sdadsp/LEDMAT3/FPGA/LED_MAT3_REV2/docs/basic_requirements.docx

20171005

Refresh rate measurements:

PWM Quantum | Number of Panels | Color Depth | Timing Data
1 (50 ns @ 20MHz SCLK) | 5 (64x64) | 8 bit @ color | 1-bit Line WR Cycle: 16 us Line WR Cycle: 144 us Frame Cycle: 4.6 ms Refresh Rate: 217Hz
15 (760 ns @ 20MHz) | 5 | 8 bit | Line WR Cycle: 322 us Frame Cycle: 10 ms Refresh Rate: 100Hz

20171006

Controls:

| OFF | ON
SW[9] | DPI Clock Input | Internal 25 MHz

Prices comparison:

10M40DCF256C8G (http://analytics.supplyframe.com/trackingservlet/track/) | 10M25DAF256C8G (http://analytics.supplyframe.com/trackingservlet/track/) | 10CL040YF484I7G (http://analytics.supplyframe.com/trackingservlet/track/) | 10CL025YU256I7G (http://analytics.supplyframe.com/trackingservlet/track/)
RAM: 1,260 Kb | 675 Kb | 1,134 Kb | 594 Kb
LED Modules: 12 x (64x64) | 6 x (64x64) | 10 x (64x64) | 6 x (64x64)
Price: $60 (it is possible to upgrade to 10M50) (it is possible downgrade to $50 10M25) | $50 (it is possible to downgrade to $30 10M16) | $40 (it is possible to upgrade to 10CL055) (it is NOT possible to downgrade to 10CL025) | $25 (it is NOT possible to upgrade to 10CL040) (it is possible to downgrade to $30 10CL016)
Additionally: | | + EPCQ16 ($7) | + EPCQ16 ($7)
Price: | | = $47 | = $32

Additionally: + QSPI ($2)

Additionally: + PSU ($5)

Additionally: + Connectors/Switches ($3)

Additionally: + PCB ($5)
Price: $75 | $65 | $62 | $47
Resources: | | + 2 weeks for SCH/PCB
| + 1 month design time to add external memory + $5 – memory chip | | + 1 month design time to add external memory + $5 – memory chip
Total: $75 | $70 | $67 | $53

Required resources

Nnumbers of pins:

CLOCKS | 3
SDRAM | 39
VGA | 14
KEYS | 2
LEDS | 2
SWITHES | 2
HUB75 | 42
DPI | 28
QSPI | 6
UART | 2
I2C | 2
MCU Interface | 4
TOTAL: | 146

- BGA256

Memory:

LED Panels: | Bits:
12 x (64x64) | 1,179,648
10 x (64x64) | 983,040
6 x (64x64) | 589,824
