sdadsp/LEDMAT3/FPGA/LED_MAT3_REV2/docs/20180509_files_list.docx

LED_MATRIX

The modules in the firmware project (by 20171105):

top.v | Top interconnections module
defines.vh | Main parameters
version_num.v version_num.tcl | Firmware version – vector connected to the registers’ file
test_pattern_generator.v vga_controller.v video_sync_generator.v video_address_generator.v | Test pattern generator
uart_rxtx.v uart.v uart_fifo.v | UART
dpi_sync_detector.v | Input data sync detector
freq_measure.v | Input video data frequency meter
stb_extender.v | strobe extender (to transfer a strobe from a fast to the slow clock domain)
strobe_gen_1k_10_5_1.v | Time-based strobes generator
regfile_uart_mapper.v | Registers’ file
pwm.v | PWM for brightness control
pll1.v | Main PLL
pll_video_input.v | DPI (Video) input PLL
outbuf_dpram.v | Video-buffer with initialization by logo2_.mif
hub75_drv.v | MBI5124 and ICN2038 -based LED matrix’s driver
~~\mbi5153_drv\~~ ~~mbi5153_~~~~commands.v~~ ~~mbi5153_~~~~data.v~~ ~~mbi5153_~~~~frame.v~~ ~~mbi5153_~~~~top.v~~ ~~fsm_rq_~~~~rdy.v~~ | ~~Files for supporting MBI5153 driver~~ ~~Sending commands~~ ~~Sending video-data (1 line per request)~~ ~~Sending 1 frame~~ ~~Config, send frame, send~~ ~~VSync~~~~, GCLK control, etc.~~ ~~Latching request and interacting with its end~~ ~~“~~~~customer~~~~”~~
image_clipper.v | DPI (Video) data clipping
dpi_recevier.v | Simple input video-data synchronizer & counter

Tools:

bmp256x64_2mif.m – make a MIF logo for initializing DPRAM

bmp360x90_2_bmp120x270.m – converting a picture for the matrix driven by Linsn modules
