sdadsp/LEDMAT3/PCB/LED_MAT_3/Release2/Project Outputs for LED_MAT_3/Fabrication/Report Board Stack/LED_MAT_3_2.0(2018-09-01).xls

Board Stack Report
Stack Up |  | Layer Stack
Layer | Board Layer Stack | Name | Material | Thickness | Constant
1 |  | Top Paste
2 |  | Top Overlay
3 |  | Top Solder | Solder Resist | 0.010mm | 3.5
4 |  | Top Layer | Copper | 0.018mm
5 |  | Dielectric 1 | 2x1080 | 0.132mm | 4.2
6 |  | Internal Plane 1 | Copper | 0.036mm
7 |  | Dielectric 4 | FR-4 | 0.450mm | 4.2
8 |  | Signal Layer 1 | Copper | 0.036mm
9 |  | Dielectric 5 | 3x1080 | 0.198mm | 4.2
10 |  | Signal Layer 2 | Copper | 0.036mm
11 |  | Dielectric 3 | FR-4 | 0.450mm | 4.2
12 |  | Internal Plane 2 | Copper | 0.036mm
13 |  | Dielectric 2 | 2x1080 | 0.132mm | 4.2
14 |  | Bottom Layer | Copper | 0.018mm
15 |  | Bottom Solder | Solder Resist | 0.010mm | 3.5
16 |  | Bottom Overlay
17 |  | Bottom Paste
 | Height : 1.562mm
