sdadsp/LEDMAT3/FPGA/LED_MAT3_REV2/docs/mbi5153_drv_and_memory_map.docx

// Date: 20171206 // Author: DS // “How to program MBI5153”

Suppose, we have 3 (M) driver ICs connected into the chain, and each IC has 4 (N) channels.

Define the uppermost pixel address in the row (line) : UPA = LBA + N · M - 1;

Then the image map in the memory will be looked as following:

1) RAM_ADDR = UPA

RAM_ADDR | LBA (Line Base Addr) | | | UPA – 2N | | | | UPA - N | | | | UPA
Line0 | IC1 Ch0 | IC1 Ch1 | IC1 Ch2 | IC1 Ch3 | IC2 Ch0 | IC2 Ch1 | IC2 Ch2 | IC2 Ch3 | IC3 Ch0 | IC3 Ch1 | IC3 Ch2 | IC3 Ch3
Line1 | IC1 Ch0 | IC1 Ch1 | IC1 Ch2 | IC1 Ch3 | IC2 Ch0 | IC2 Ch1 | IC2 Ch2 | IC2 Ch3 | IC3 Ch0 | IC3 Ch1 | IC3 Ch2 | IC3 Ch3
Line2 | IC1 Ch0 | IC1 Ch1 | IC1 Ch2 | IC1 Ch3 | IC2 Ch0 | IC2 Ch1 | IC2 Ch2 | IC2 Ch3 | IC3 Ch0 | IC3 Ch1 | IC3 Ch2 | IC3 Ch3

2) RAM_ADDR = UPA – 1

RAM_ADDR | | | UPA – 1 – 2N | | | | UPA – 1 – N | | | | UPA - 1
Line0 | IC1 Ch0 | IC1 Ch1 | IC1 Ch2 | IC1 Ch3 | IC2 Ch0 | IC2 Ch1 | IC2 Ch2 | IC2 Ch3 | IC3 Ch0 | IC3 Ch1 | IC3 Ch2 | IC3 Ch3
Line1 | IC1 Ch0 | IC1 Ch1 | IC1 Ch2 | IC1 Ch3 | IC2 Ch0 | IC2 Ch1 | IC2 Ch2 | IC2 Ch3 | IC3 Ch0 | IC3 Ch1 | IC3 Ch2 | IC3 Ch3
Line2 | IC1 Ch0 | IC1 Ch1 | IC1 Ch2 | IC1 Ch3 | IC2 Ch0 | IC2 Ch1 | IC2 Ch2 | IC2 Ch3 | IC3 Ch0 | IC3 Ch1 | IC3 Ch2 | IC3 Ch3

3) RAM_ADDR = UPA – 2

RAM_ADDR | | UPA – 2 – 2N | | | | UPA – 2 – N | | | | UPA - 2
Line0 | IC1 Ch0 | IC1 Ch1 | IC1 Ch2 | IC1 Ch3 | IC2 Ch0 | IC2 Ch1 | IC2 Ch2 | IC2 Ch3 | IC3 Ch0 | IC3 Ch1 | IC3 Ch2 | IC3 Ch3
Line1 | IC1 Ch0 | IC1 Ch1 | IC1 Ch2 | IC1 Ch3 | IC2 Ch0 | IC2 Ch1 | IC2 Ch2 | IC2 Ch3 | IC3 Ch0 | IC3 Ch1 | IC3 Ch2 | IC3 Ch3
Line2 | IC1 Ch0 | IC1 Ch1 | IC1 Ch2 | IC1 Ch3 | IC2 Ch0 | IC2 Ch1 | IC2 Ch2 | IC2 Ch3 | IC3 Ch0 | IC3 Ch1 | IC3 Ch2 | IC3 Ch3

4) RAM_ADDR = UPA – 3

RAM_ADDR | UPA – 3 – 2N | | | | UPA – 3 – N | | | | UPA - 3
Line0 | IC1 Ch0 | IC1 Ch1 | IC1 Ch2 | IC1 Ch3 | IC2 Ch0 | IC2 Ch1 | IC2 Ch2 | IC2 Ch3 | IC3 Ch0 | IC3 Ch1 | IC3 Ch2 | IC3 Ch3
Line1 | IC1 Ch0 | IC1 Ch1 | IC1 Ch2 | IC1 Ch3 | IC2 Ch0 | IC2 Ch1 | IC2 Ch2 | IC2 Ch3 | IC3 Ch0 | IC3 Ch1 | IC3 Ch2 | IC3 Ch3
Line2 | IC1 Ch0 | IC1 Ch1 | IC1 Ch2 | IC1 Ch3 | IC2 Ch0 | IC2 Ch1 | IC2 Ch2 | IC2 Ch3 | IC3 Ch0 | IC3 Ch1 | IC3 Ch2 | IC3 Ch3

Next Line:

1) UPA = UPA + N · M

RAM_ADDR | LBA (Line Base Addr) | | | UPA – 2N | | | | UPA - N | | | | UPA
Line0 | IC1 Ch0 | IC1 Ch1 | IC1 Ch2 | IC1 Ch3 | IC2 Ch0 | IC2 Ch1 | IC2 Ch2 | IC2 Ch3 | IC3 Ch0 | IC3 Ch1 | IC3 Ch2 | IC3 Ch3
Line1 | IC1 Ch0 | IC1 Ch1 | IC1 Ch2 | IC1 Ch3 | IC2 Ch0 | IC2 Ch1 | IC2 Ch2 | IC2 Ch3 | IC3 Ch0 | IC3 Ch1 | IC3 Ch2 | IC3 Ch3
Line2 | IC1 Ch0 | IC1 Ch1 | IC1 Ch2 | IC1 Ch3 | IC2 Ch0 | IC2 Ch1 | IC2 Ch2 | IC2 Ch3 | IC3 Ch0 | IC3 Ch1 | IC3 Ch2 | IC3 Ch3
