sdadsp/LEDMAT3/FPGA/LED_MAT3_REV2/docs/led_array_controller_rev2.jpg

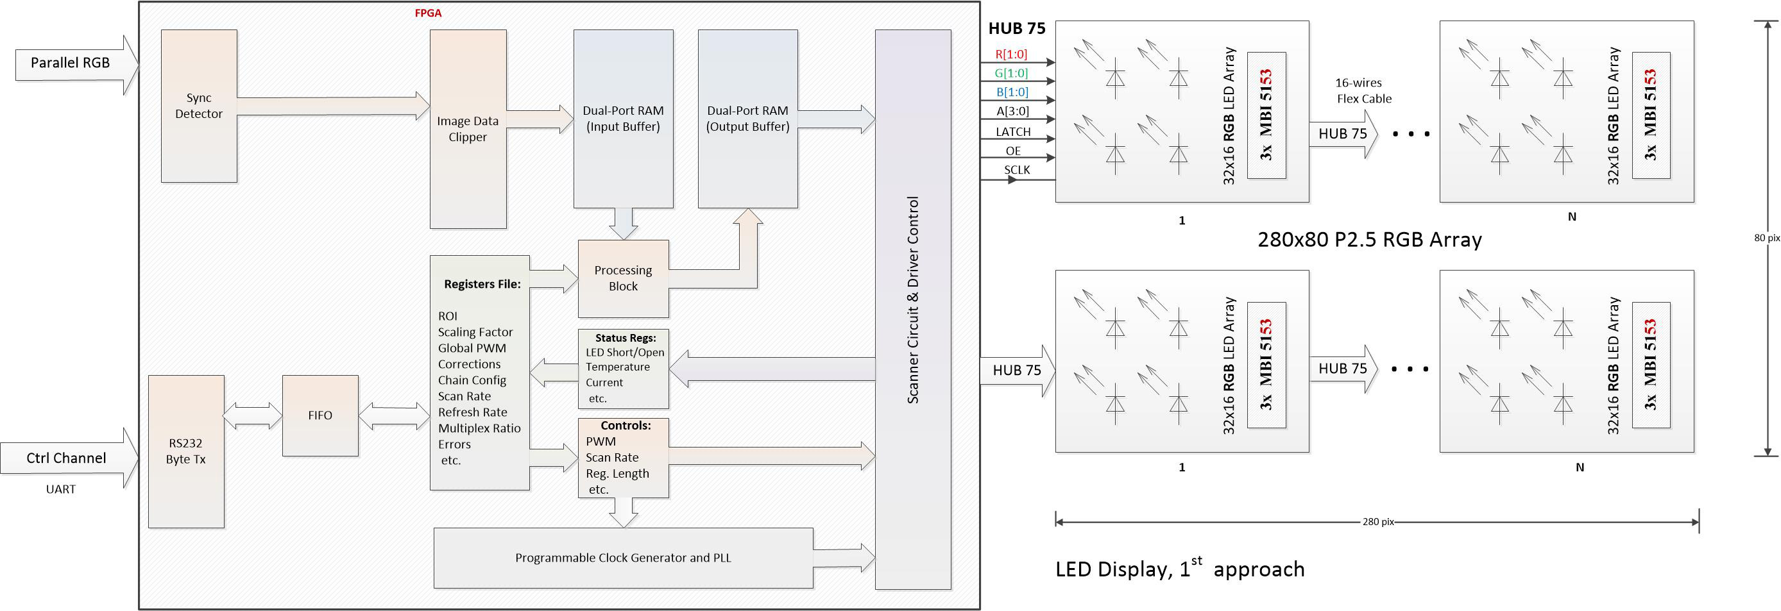
FPGA/LED_MAT3_REV2/docs/led_array_controller_rev2.jpg
