sdadsp/LEDMAT3/FPGA/LED_MAT3_REV2/docs/led_matrix_clock_tree_v1.jpg

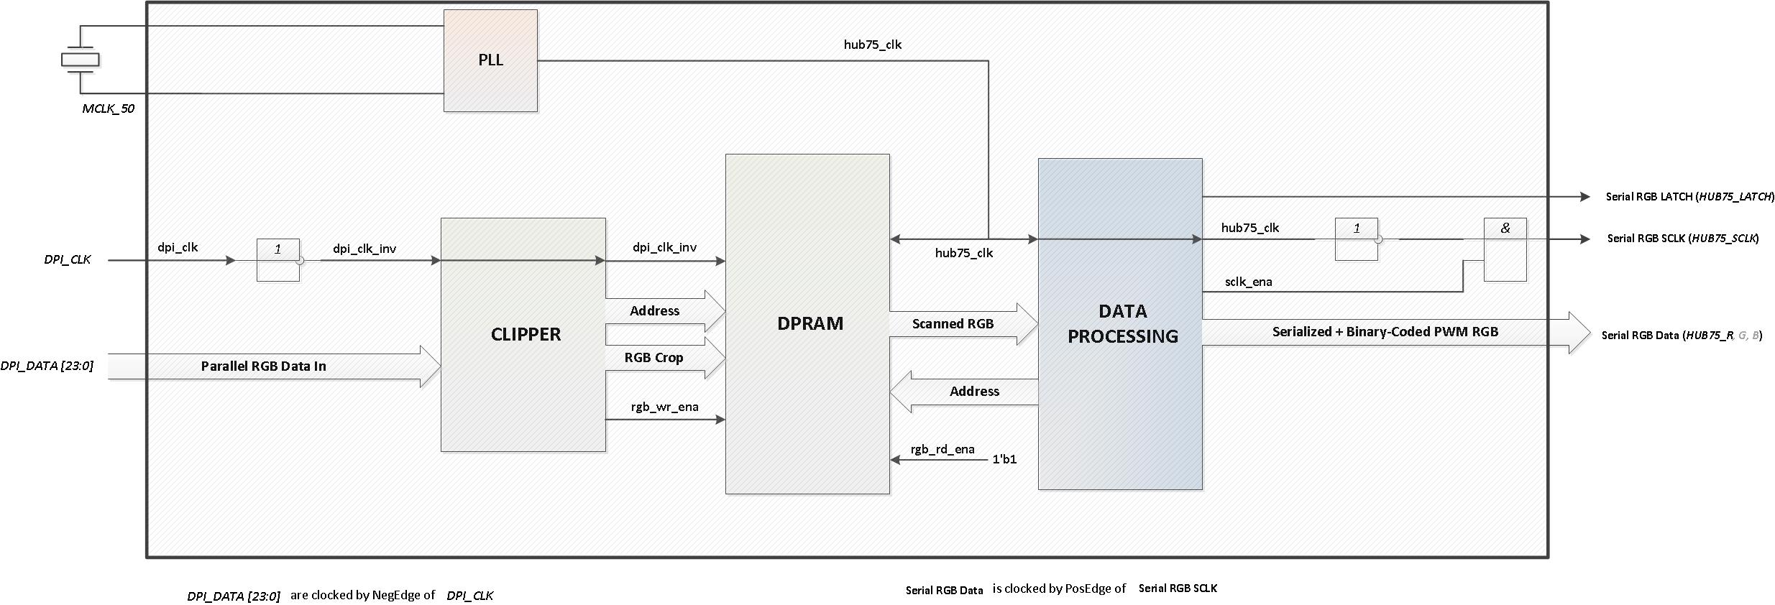
FPGA/LED_MAT3_REV2/docs/led_matrix_clock_tree_v1.jpg
