sdadsp/LEDMAT3/FPGA/LED_MAT3_REV2/hub75_drv/simulation/20170901/2.JPG

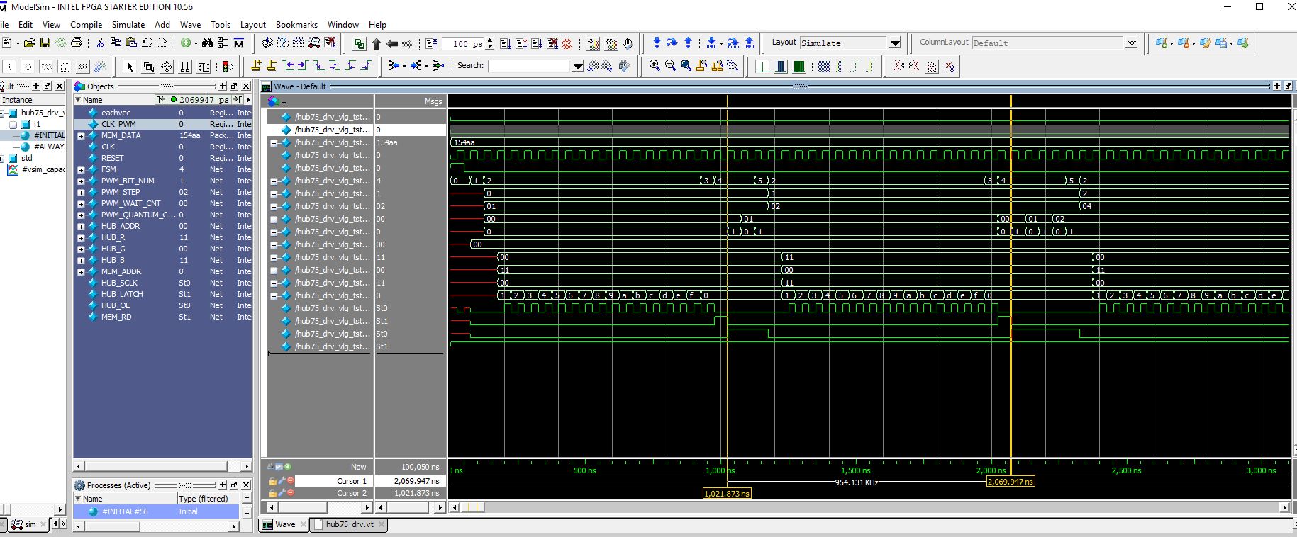
FPGA/LED_MAT3_REV2/hub75_drv/simulation/20170901/2.JPG
