sdadsp/LEDMAT3/FPGA/LED_MAT3_REV2/mbi5153_drv/simulations/mbi5153_commands/temp/wave_201710271730.bmp

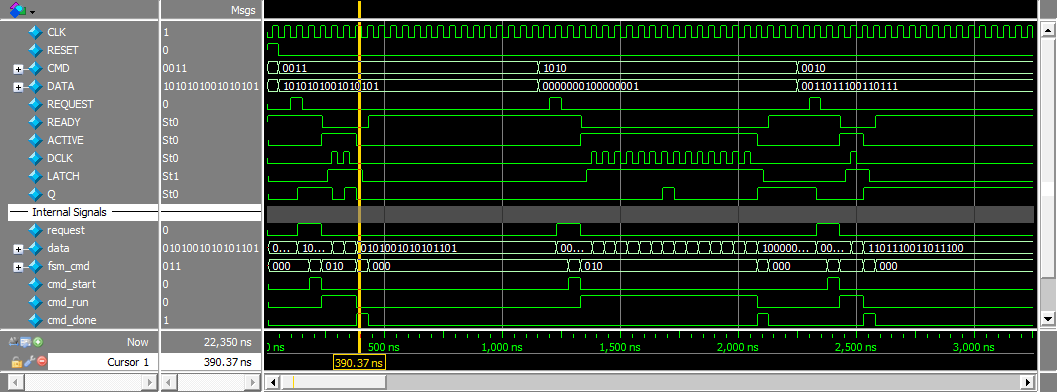
FPGA/LED_MAT3_REV2/mbi5153_drv/simulations/mbi5153_commands/temp/wave_201710271730.bmp
