sdadsp/LEDMAT3/FPGA/LED_MAT3_REV2/mbi5153_drv/simulations/mbi5153_data/201712141727_mbi5153_data_sim_out.bmp

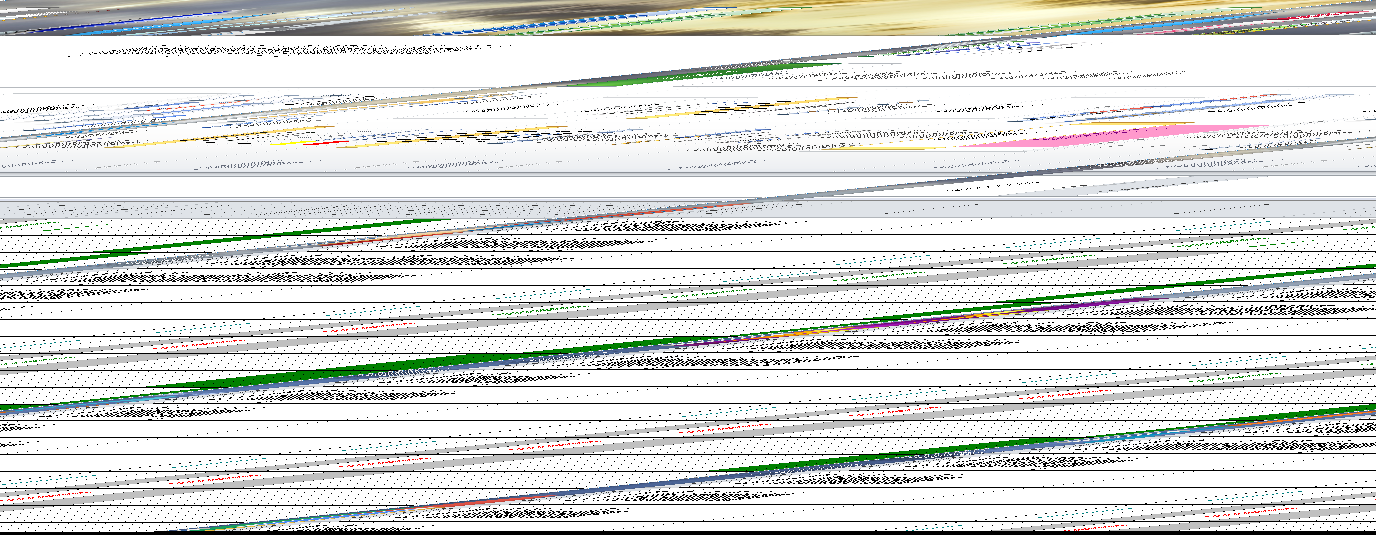
FPGA/LED_MAT3_REV2/mbi5153_drv/simulations/mbi5153_data/201712141727_mbi5153_data_sim_out.bmp
