sdadsp/LEDMAT3/FPGA/LED_MAT3_REV2/mbi5153_drv/simulations/mbi5153_data/201712181715_mbi5153_data_sim_out.png

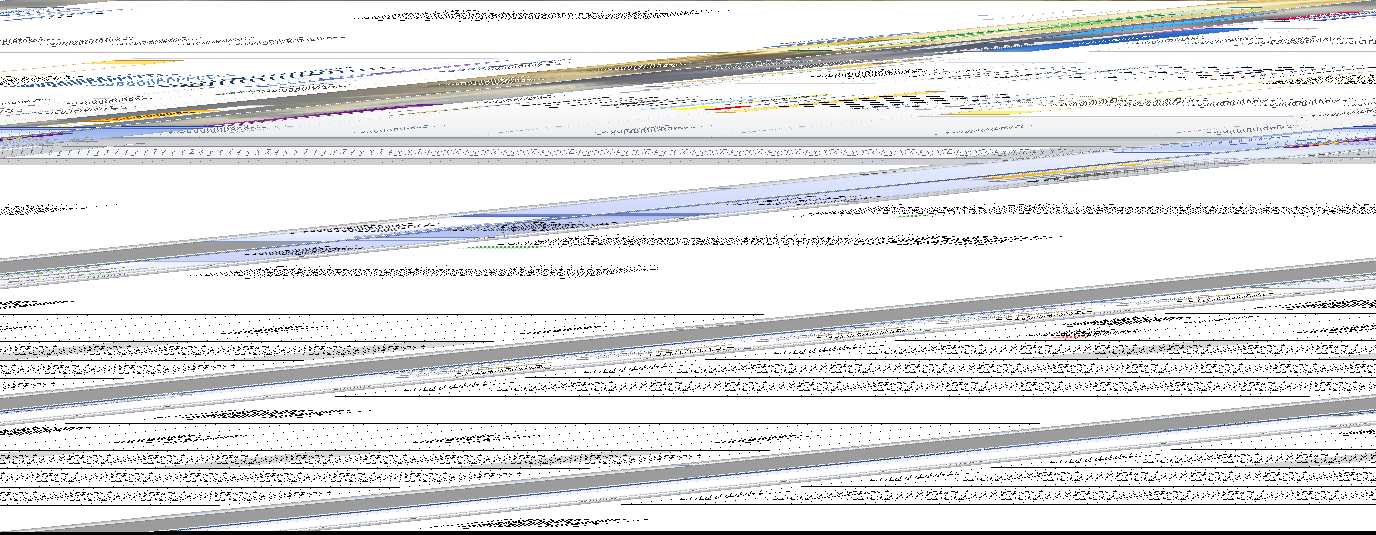
FPGA/LED_MAT3_REV2/mbi5153_drv/simulations/mbi5153_data/201712181715_mbi5153_data_sim_out.png
