sdadsp/LEDMAT3/FPGA/LED_MAT3_REV2/mbi5153_drv/simulations/mbi5153_data/temp/201711241648.bmp

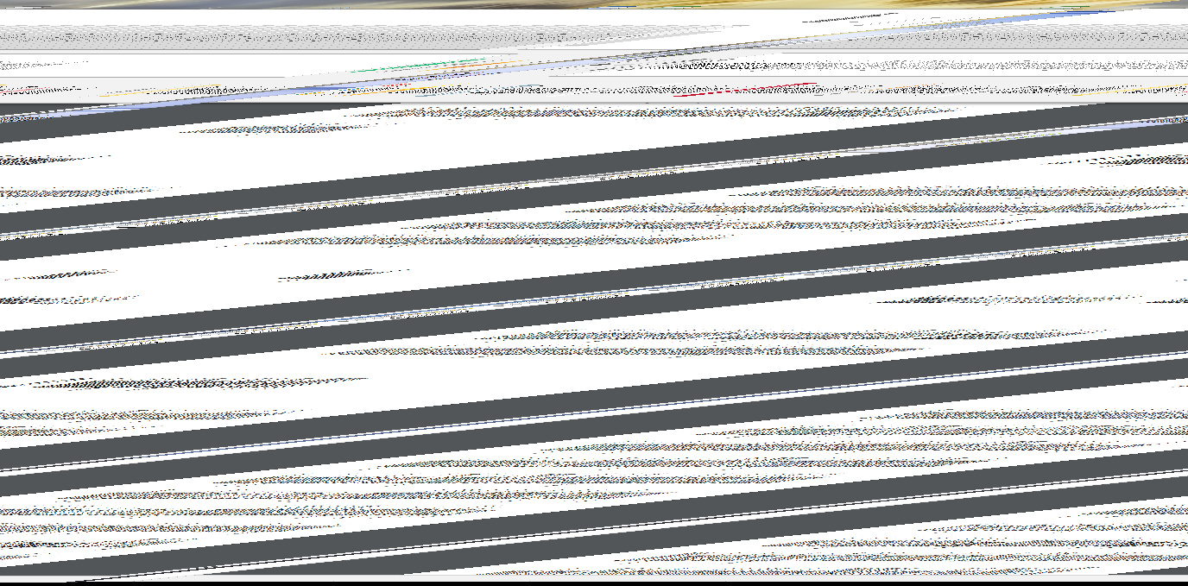
FPGA/LED_MAT3_REV2/mbi5153_drv/simulations/mbi5153_data/temp/201711241648.bmp
