sdadsp/LEDMAT3/FPGA/LED_MAT3_REV2/mbi5153_drv/simulations/mbi5153_data/wave_201801201655_2.JPG

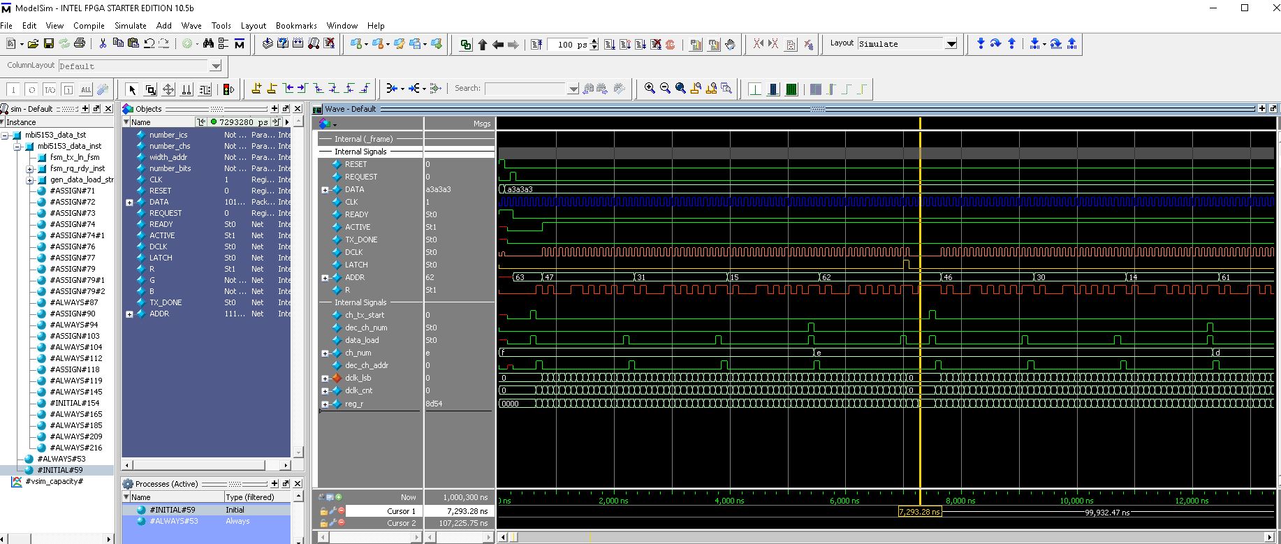
FPGA/LED_MAT3_REV2/mbi5153_drv/simulations/mbi5153_data/wave_201801201655_2.JPG
