sdadsp/LEDMAT3/FPGA/LED_MAT3_REV2/mbi5153_drv/simulations/mbi5153_rcfg/wave_20180112_1st-approach.JPG

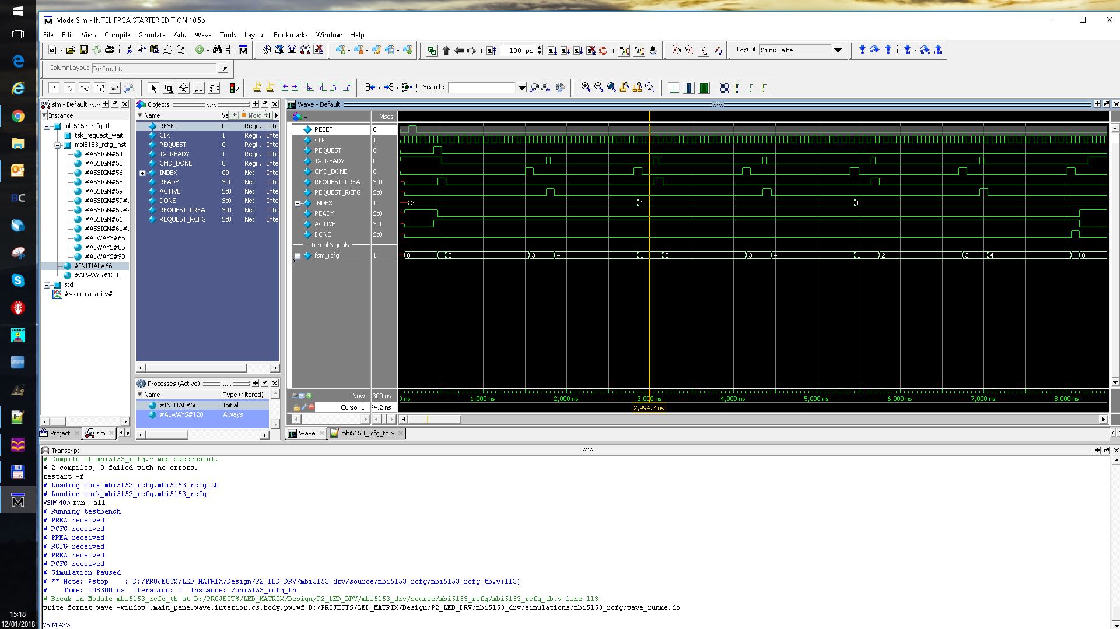
FPGA/LED_MAT3_REV2/mbi5153_drv/simulations/mbi5153_rcfg/wave_20180112_1st-approach.JPG
