sdadsp/LEDMAT3/FPGA/LED_MAT3_REV2/mbi5153_drv/simulations/mbi5153_rcfg_cmd/wave_20180113_rcfg_1-cycle.JPG

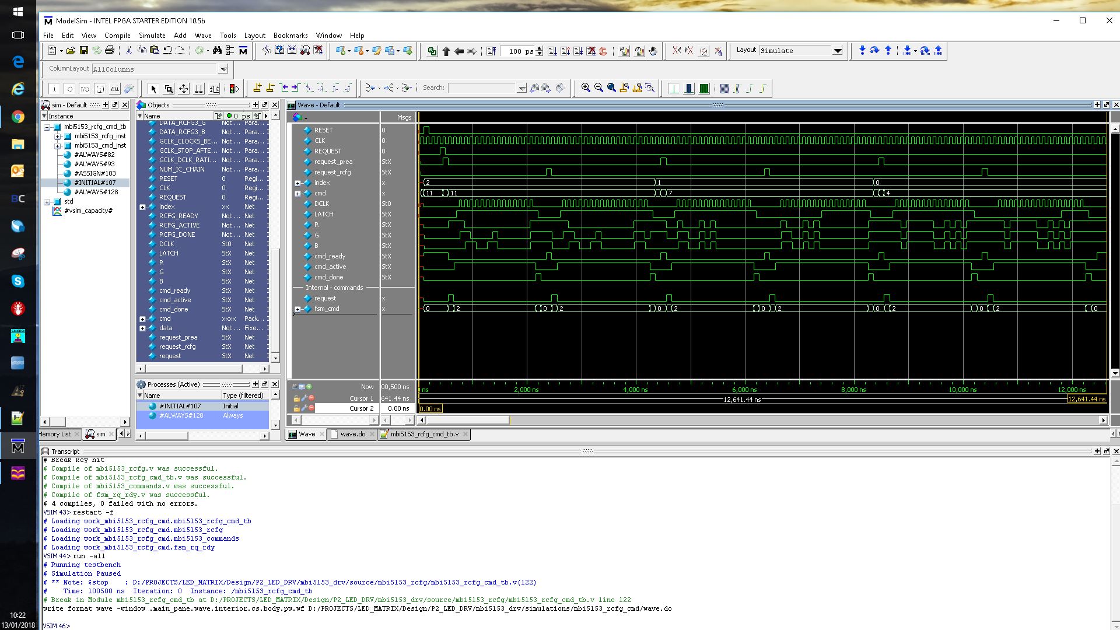
FPGA/LED_MAT3_REV2/mbi5153_drv/simulations/mbi5153_rcfg_cmd/wave_20180113_rcfg_1-cycle.JPG
