sdadsp/LEDMAT3/FPGA/LED_MAT3_REV2/mbi5153_drv/simulations/mbi5153_top/20180125/config_registers_writing (reg3).PNG

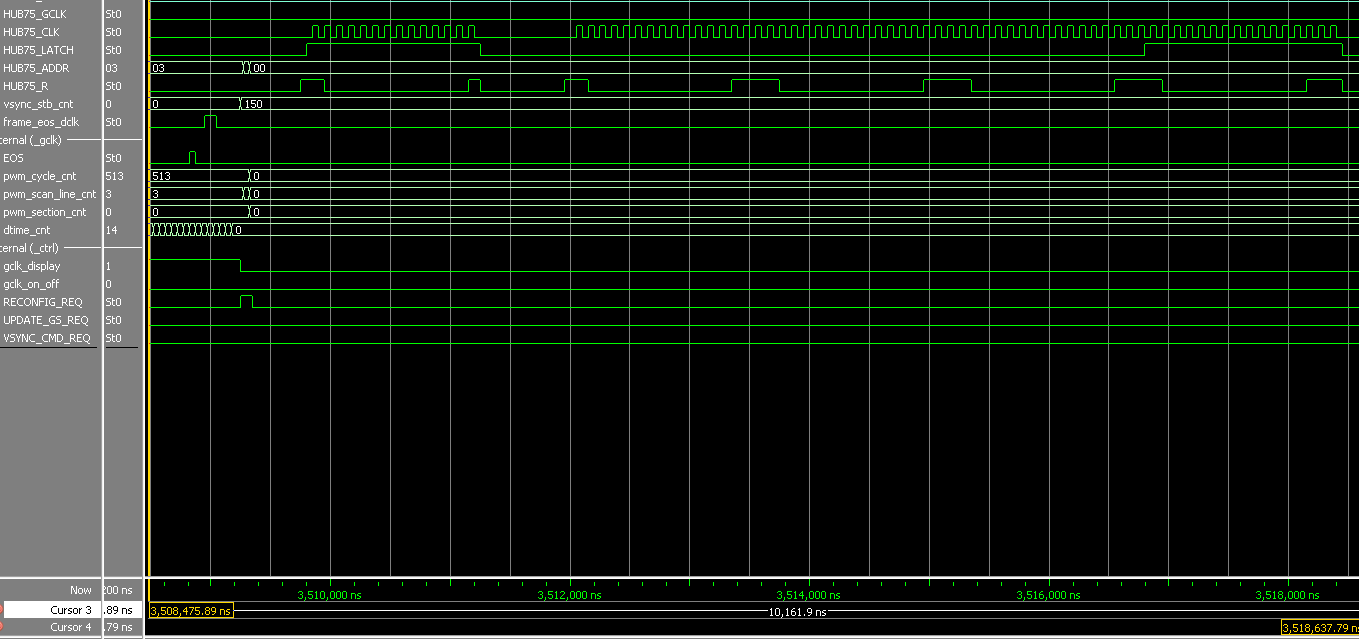
FPGA/LED_MAT3_REV2/mbi5153_drv/simulations/mbi5153_top/20180125/config_registers_writing (reg3).PNG
