sdadsp/LEDMAT3/FPGA/LED_MAT3_REV2/mbi5153_drv/simulations/mbi5153_top/20180125/dead_time_between_sections.PNG

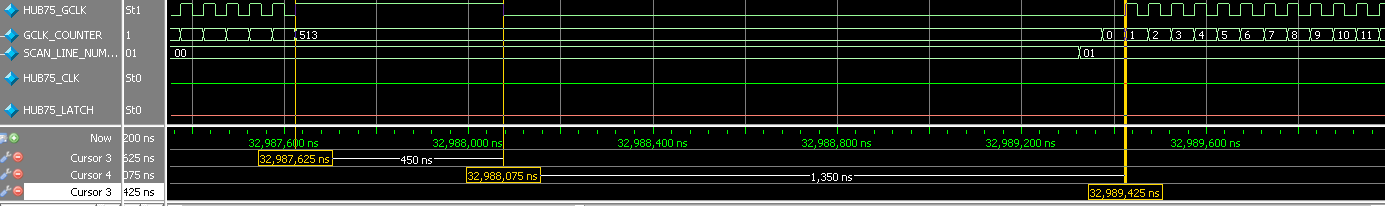
FPGA/LED_MAT3_REV2/mbi5153_drv/simulations/mbi5153_top/20180125/dead_time_between_sections.PNG
