sdadsp/LEDMAT3/FPGA/LED_MAT3_REV2/mbi5153_drv/simulations/mbi5153_top/20180125/end-of-update_GS_and_VSYNC_and_beginning_of_displaying_GS (frame scan).PNG

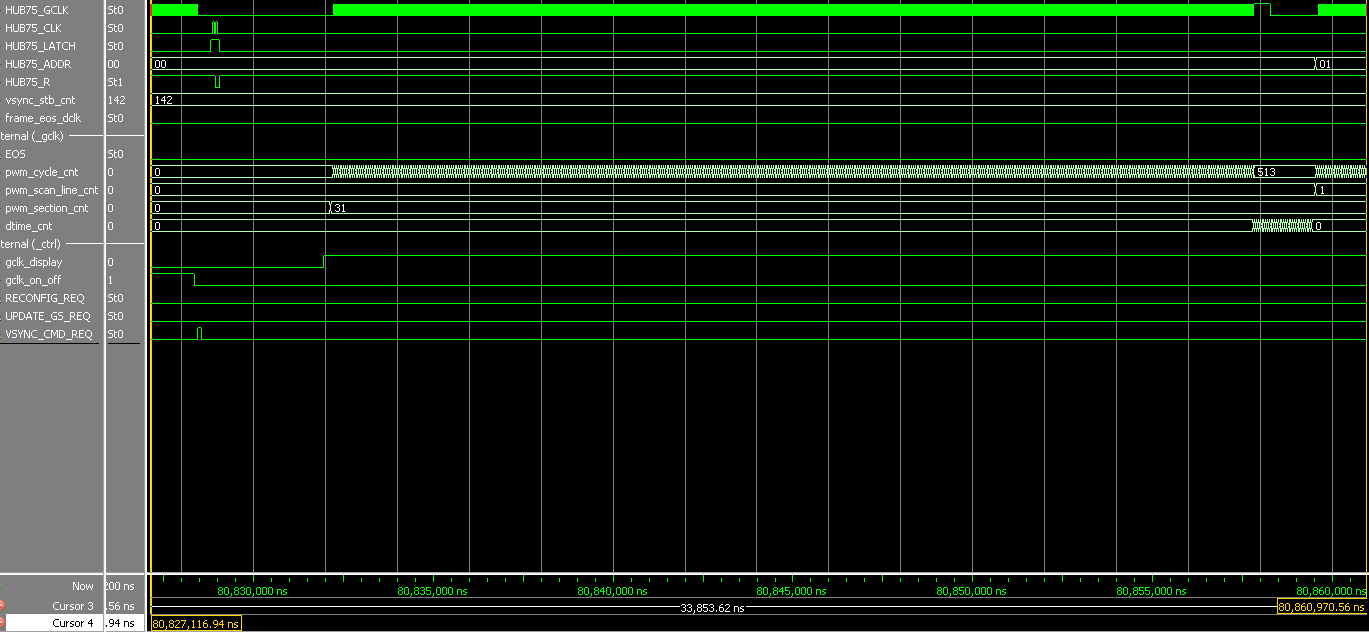
FPGA/LED_MAT3_REV2/mbi5153_drv/simulations/mbi5153_top/20180125/end-of-update_GS_and_VSYNC_and_beginning_of_displaying_GS (frame scan).PNG
