sdadsp/LEDMAT3/FPGA/LED_MAT3_REV2/mbi5153_drv/simulations/mbi5153_top/20180125/frame_scan_dead-time_between_line-0_and_line-1.JPG

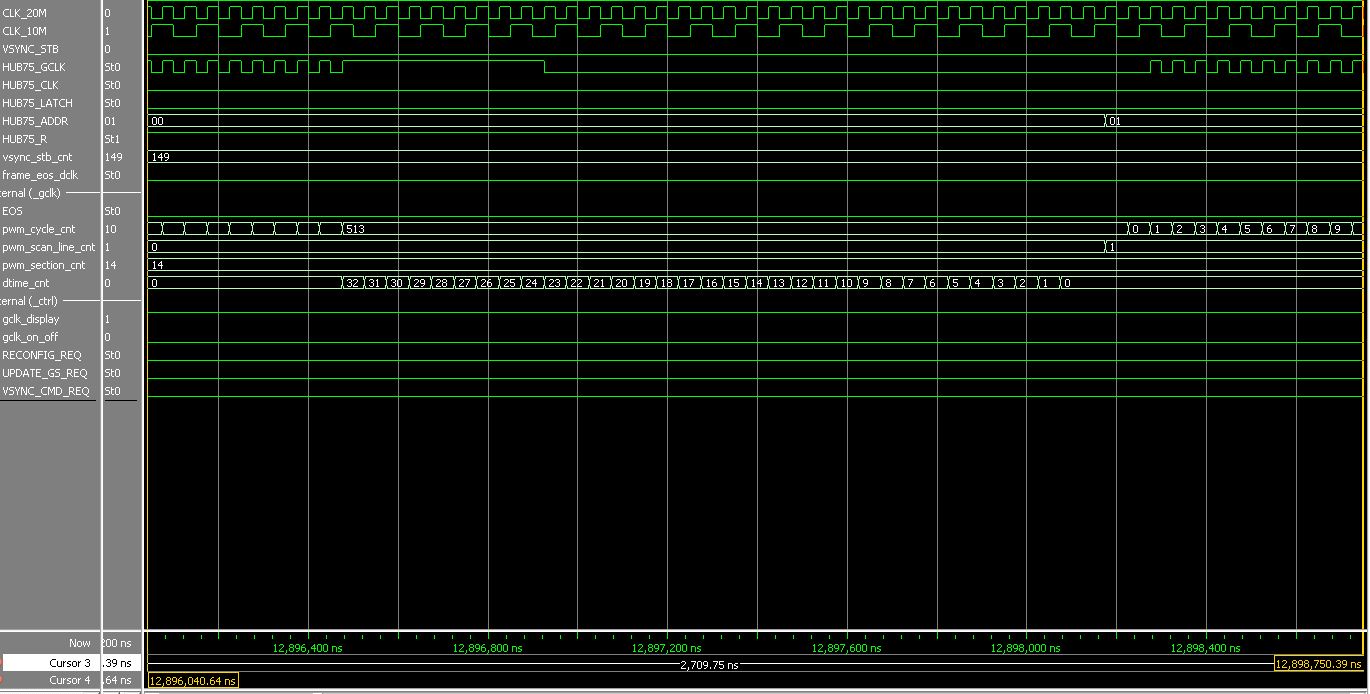
FPGA/LED_MAT3_REV2/mbi5153_drv/simulations/mbi5153_top/20180125/frame_scan_dead-time_between_line-0_and_line-1.JPG
