sdadsp/LEDMAT3/FPGA/LED_MAT3_REV2/mbi5153_drv/simulations/mbi5153_top/20180125/frame_scan_last_section_in_the_cycle (14-bit pwm).PNG

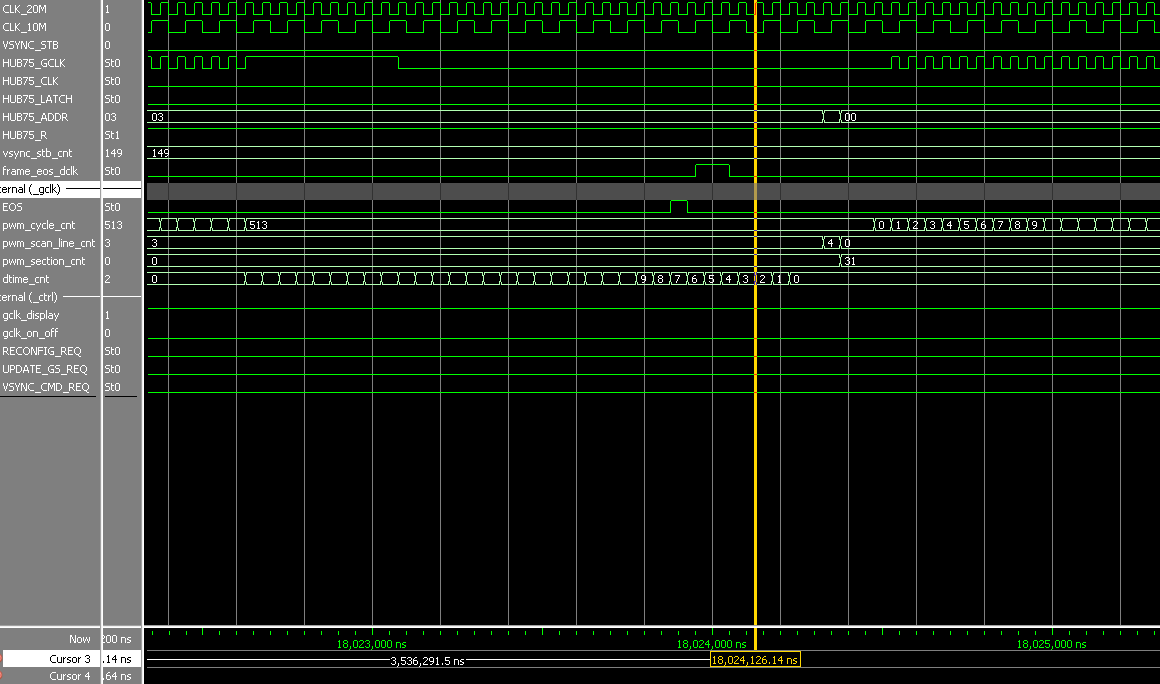
FPGA/LED_MAT3_REV2/mbi5153_drv/simulations/mbi5153_top/20180125/frame_scan_last_section_in_the_cycle (14-bit pwm).PNG
