sdadsp/LEDMAT3/FPGA/LED_MAT3_REV2/mbi5153_drv/simulations/mbi5153_top/20180125/frame_scan_line-0_of_1-section (4 lines).JPG

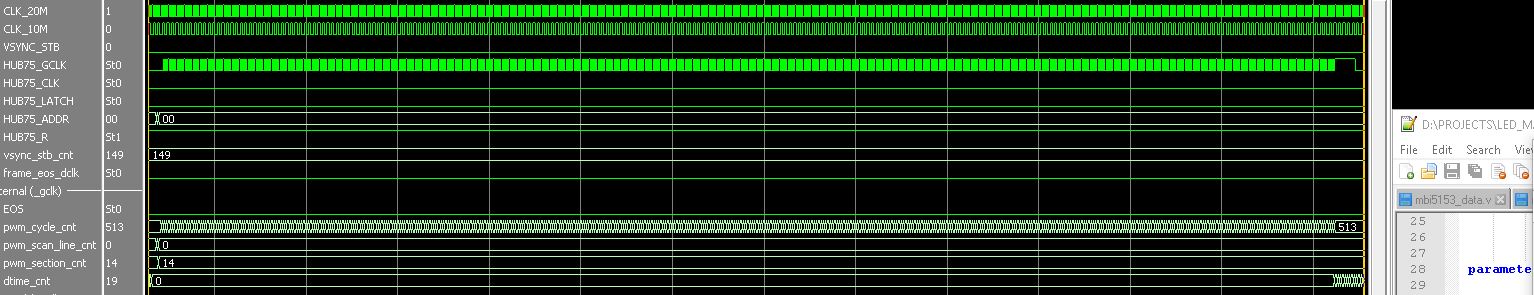
FPGA/LED_MAT3_REV2/mbi5153_drv/simulations/mbi5153_top/20180125/frame_scan_line-0_of_1-section (4 lines).JPG
