sdadsp/LEDMAT3/FPGA/LED_MAT3_REV2/mbi5153_drv/simulations/mbi5153_top/20180125/frame_scan_vertical-sync-detected_then_update_GS_started_after_end-of-scan.PNG

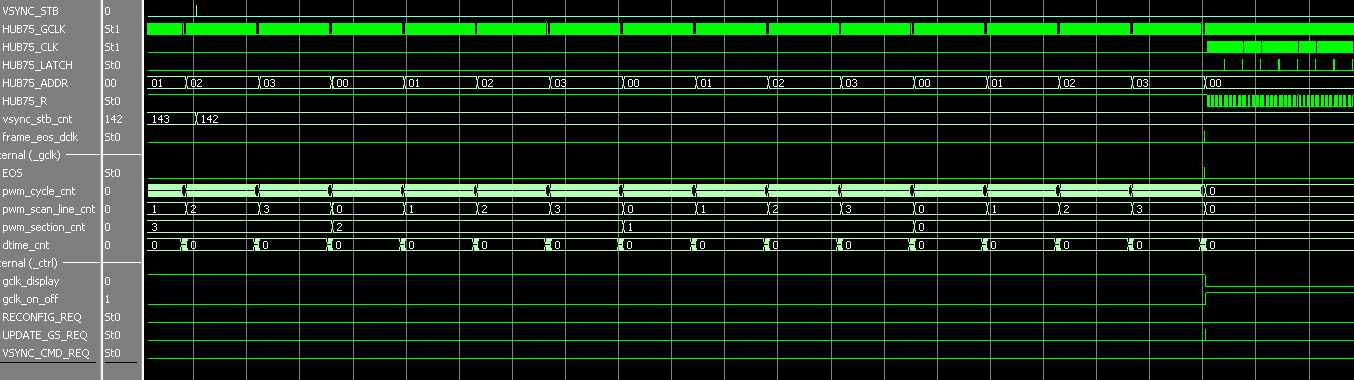
FPGA/LED_MAT3_REV2/mbi5153_drv/simulations/mbi5153_top/20180125/frame_scan_vertical-sync-detected_then_update_GS_started_after_end-of-scan.PNG
