sdadsp/LEDMAT3/FPGA/LED_MAT3_REV2/mbi5153_drv/simulations/mbi5153_top/20180125/update_GS_beginning (4 drivers in the chain)_zoom-in_view.PNG

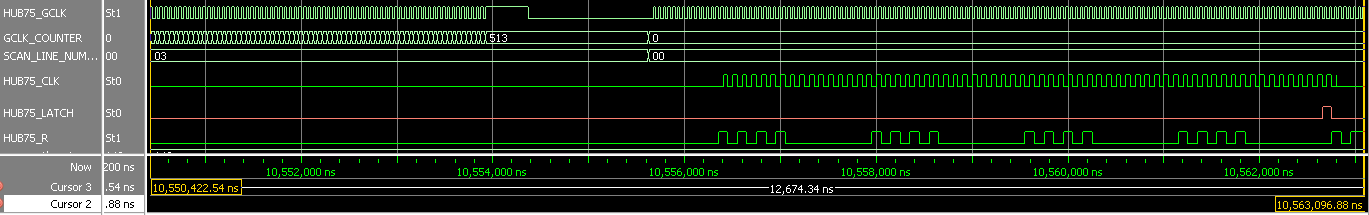
FPGA/LED_MAT3_REV2/mbi5153_drv/simulations/mbi5153_top/20180125/update_GS_beginning (4 drivers in the chain)_zoom-in_view.PNG
