sdadsp/LEDMAT3/FPGA/LED_MAT3_REV2/mbi5153_drv/simulations/mbi5153_top/20180125/update_GS_cycle (4 drivers x 4 lines).PNG

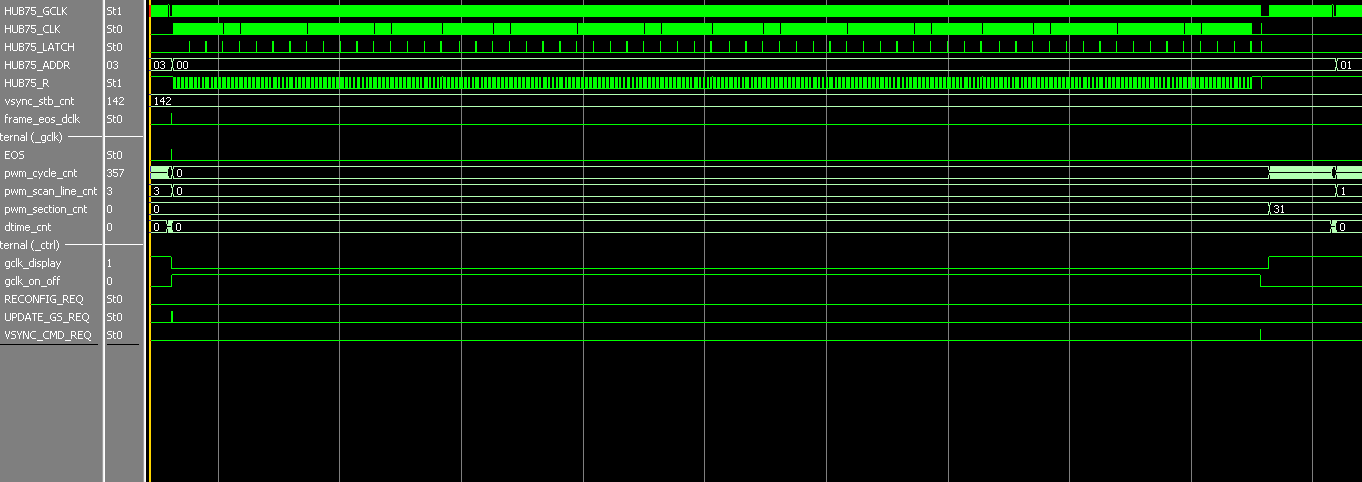
FPGA/LED_MAT3_REV2/mbi5153_drv/simulations/mbi5153_top/20180125/update_GS_cycle (4 drivers x 4 lines).PNG
