sdadsp/LEDMAT3/FPGA/LED_MAT3_REV2/mbi5153_drv/simulations/mbi5153_top/20180125/update_GS_end-of-cycle_and_VSYNC-generation.PNG

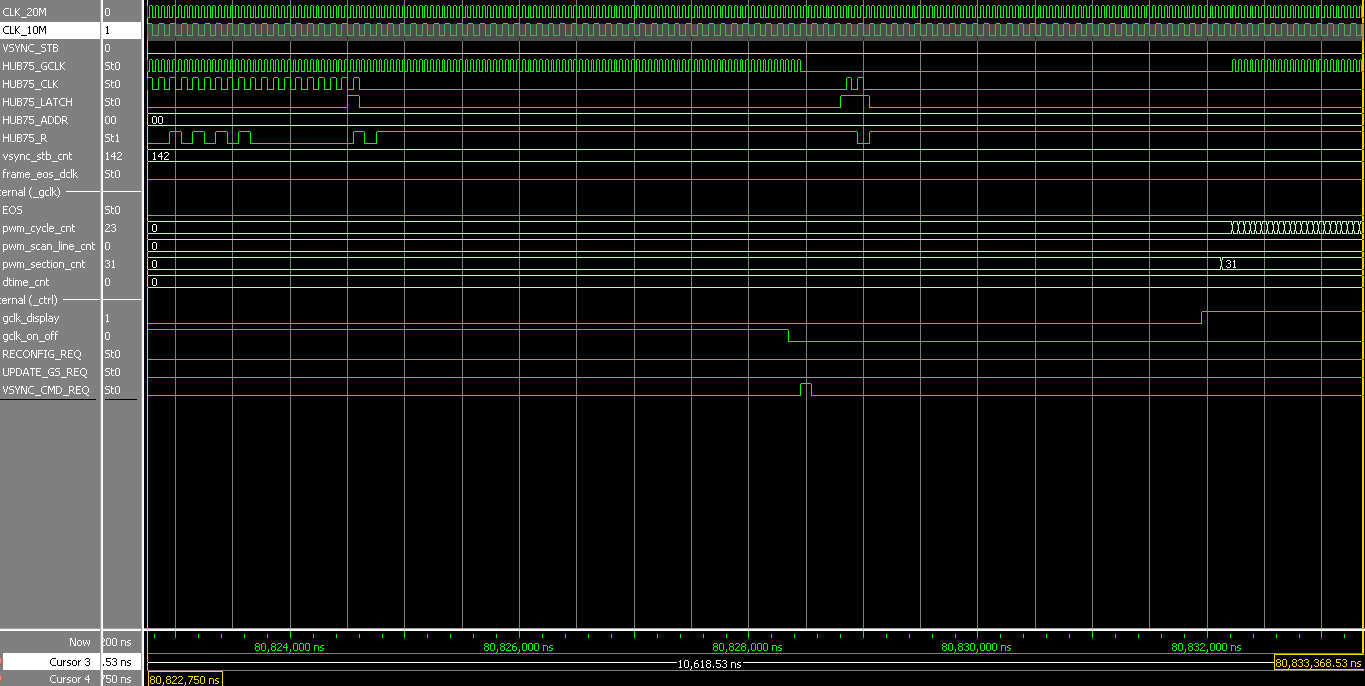
FPGA/LED_MAT3_REV2/mbi5153_drv/simulations/mbi5153_top/20180125/update_GS_end-of-cycle_and_VSYNC-generation.PNG
