sdadsp/LEDMAT3/PCB/LED_MAT_3/Release2/impedance_calculus.JPG

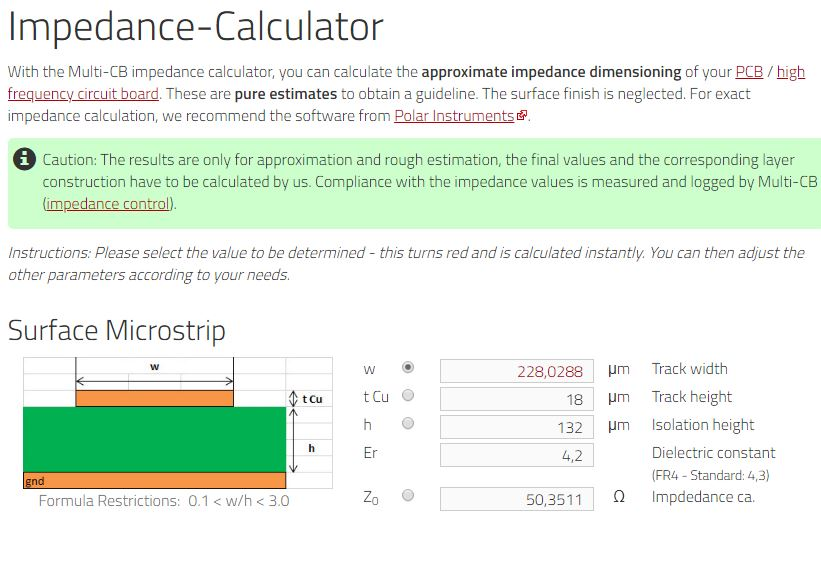
PCB/LED_MAT_3/Release2/impedance_calculus.JPG
