sdadsp/LEDMAT3/PCB/LED_MAT_3/Release2/Project Outputs for LED_MAT_3/BOM/BOM_LED_MAT_3.xls

Bill of Materials |  |  | None
BOM Origin: | Top Connections
Source Data From: | LED_MAT_3.PRJPCB
Project: | LED_MAT_3.PRJPCB
Variant: | None
Creation Date: | 05/09/2018 |  | 13:36:09
Print Date: | 2020-02-24 |  | 22:49:26
PCB Revision:
Contact Person:
Overall Requirements for mentioned components (Unless stated otherwise in Remarks)
Operating Temperature Range for all mentioned components: |  |  | 0…70
Resistor maximum error in value, over temperature range: |  |  | 1
Capacitor maximum error in value, over temperature range: |  |  | 10
Designator | Category | Type | Value | Description | Package | Manufacturer | Manufacturer Part Number | Remarks | Quantity
C1_1, C1_2, C1_3, C2_1, C2_2, C2_3, C3_1, C3_2, C3_3, C4, C7, C12, C13, C14, C15, C16, C17, C18, C19, C20, C21, C22, C23, C24, C31, C32, C33, C34, C35, C36, C37, C38, C39, C40, C41, C42, C43, C44, C45, C46, C47, C48, C49, C50, C52, C53, C54, C55, C56, C57, C58, C59, C61, C62, C64, C65, C66, C67, C69, C71, C72, C75, C77, C79, C90, C91, C95 |  |  | 100nF | Capacitor ceramic | 0402 | SAMSUNG | CL05B104KO5NNNC |  | 67
C5, C25, C28, C82, C83 |  |  | 100nF | Capacitor SMD | 0805 | SAMSUNG | CL21B104KBCNNNC |  | 5
C6 | Capacitor | COG | 22pF | Capacitor ceramic | 0603 | SAMSUNG | CL10C100JB8NNNC |  | 1
C8, C9, C30 | Capacitor | COG | 10pF | Capacitor ceramic | 0603 | SAMSUNG | CL10C100JB8NNNC |  | 3
C10, C11, C26, C27, C88 | Capacitor | NPO | 1nF | Capacitor ceramic | 0603 | MURATA | GRM1885C1H102JA01D |  | 5
C29 |  |  | 2.2uF | Capacitor SMD | 0805 | TDK | C2012X7R1C225K125AB |  | 1
C51, C68, C70, C73, C74, C76, C78, C80, C81, C84, C85, C86, C87, C89, C92 |  |  | 10uF | Capacitor ceramic | 0805 |  |  |  | 15
C93, C94, C96, C97 |  |  | 100nF | Capacitor ceramic | 0603 |  |  |  | 4
DA1 |  |  | USBLC6-2 | Very low capacitance ESD protection |  | ST | USBLC6-2SC6 |  | 1
DA2 |  |  |  | 2.5 MHz Dual Switching Regulator, 2A | TSSOP-16 | SEMTECH | SC2440TETRT |  | 1
DA3 |  |  | TPS2114A | AUTOSWITCHING POWER MUX |  | TI | TPS2114A |  | 1
DA4 |  | IC | SPX3819M5-2-5 | 500mA, Low-Noise LDO Voltage Regulator | SOT23-5 | SIPEX | SPX3819M5-2-5 |  | 1
DD1_1, DD1_2, DD1_3, DD2_1, DD2_2, DD2_3, DD3_1, DD3_2, DD3_3 |  |  |  | Octal 3-State Noninverting Bus Transceiver | SO-20 | NEXPERIA | SN74HCT245PW |  | 9
DD4 |  |  | CP2102-GMR | USB to UART bridge | QFN28 | SILICON | CP2102-GMR |  | 1
DD5 |  |  |  | FPGA | BGA256 | ALTERA | 10M40DCF256C7GA |  | 1
DD6 | I2C EEPROM | M24C64-WMN6TP | M24C64-WMN6TP | M24C64-WMN6TP | SO8 | ST | M24C64-WMN6TP | ./. | 1
DD7 |  |  |  | 8 M Low Voltage, Ultra Low Power Pseudo CMOS SRAM, 512 K x 16, -40 to 85 degC, 44-Pin SOP (TSOP-2-44), Pb-Free |  | Integrated Silicon Solution Inc (ISSI) | IS66WV51216DBLL-55TLI |  | 1
IC1, IC3 | Diode |  | SRV05-4 | Low Capacitance Transient Voltage Suppressors Diode Array | SOT23-6L | SEMTECH | SRV05-4.TCT | ./. | 2
IC2 |  |  | 1Kbit E2PROM | 1K I2C Serial EEPROM | SO-8 | MICROCHIP | 24LC01BT-I/SN |  | 1
J1 |  |  | USB2X02SR-H | USB-B | USB-B | AUK | USB2X02SR-H |  | 1
JP1 | Header | Header 1x3, 2.54mm | Header 1x3, 2.54mm | Header, 3-Pin | Header 1x3, 2.54mm | JIH VEI | 21B1264-03S10-01G-6/3 | replaceable | 1
L1, L10 |  |  | 2.2uH | Power choke | 0404 | TAIYO YUDE | NR4018T2R2M |  | 2
L2, L4, L5 |  |  |  | Ferrite bead | 0805 | Murata | BLM21PG221SN1 |  | 3
L3 |  |  |  | General 0402 - type Chip Inductor | 0402 | Murata | BLM15AG601SN1 |  | 1
L11 |  |  |  | Ferrite bead | 0805 | Murata | BLM21PG221SN1 |  | 1
P2 |  |  | FFC connector/40P/Female/Top contact |  |  | OUPIIN | 2345-40TD1T |  | 1
P3_1, P3_2, P3_3 |  |  |  | Header, 10-Pin, Dual row, Right Angle |  |  |  |  | 3
P4 |  |  |  | Header, 8-Pin, Dual row, Right Angle |  |  |  |  | 1
PCB | PCB | 70x127.5x1.6mm 6 Layers | 70x127.5x1.6mm 6 Layers | PNEC_Bridge_v1 PCB/FR4/1.55mm/8L/ENIG | 70x127.5x1.6mm 6 Layers | ./. | ./. | ./. | 1
R1, R2 |  |  | 5.1k | Resistor SMD | 0805 | YAGEO | RC0805FR075K1L |  | 2
R3, R4, R6, R8, R11, R12, R15, R16, R17, R25, R27, R28, R32, R33, R34, R35, R36, R40, R42, R43, R44, R51, R52, R53, R54, R55, R56, R57, R58, R59 |  |  | 10k | Resistor | 0603 |  |  |  | 30
R5, R10, R14, R18, R29, R48, R60 |  |  | 1k | Resistor | 0603 |  |  | replaceable | 7
R7, R9, R23, R26 | Resistor |  | 10R | 10R / 1% / 0603 | 0603 | YAGEO | RC0603FR-0710RL | replaceable | 4
R13 |  |  | 0R | Resistor | 0805 | YAGEO | RC0805JR-070RL | replaceable | 1
R19, R20 |  |  | 0R | Resistor | 0603 | YAGEO | RC0603FR-070RL | replaceable | 2
R21, R22 | Resistor |  | 4.7k | 4.7k / 1% / 0603 | 0603 | YAGEO | RC0603FR-074K7L | replaceable | 2
R24 | Resistor |  | 16.9k | 16.9k / 1% / 0603 | 0603 | YAGEO | RC0603FR0716K9L | replaceable | 1
R30 | Resistor |  | 13.3k | 13.3k / 1% / 0603 | 0603 | YAGEO | RC0603FR-0713K3L | replaceable | 1
R31, R45, R46, R47 | Resistor |  | 0 | 0 / 1% / 0603 | 0603 | YAGEO | RC0603FR-072KL | replaceable | 4
R37 | Resistor |  | 15k | 15k / 1% / 0603 | 0603 | YAGEO | RC0603FR-0715KL | replaceable | 1
R38 | Resistor |  | 124R | 124R / 1% / 0603 | 0603 | PANASONIC | ERJ-3EKF1240V | replaceable | 1
R39 | Resistor |  | 2k | 2k / 1% / 0603 | 0603 | YAGEO | RC0603FR-072KL | replaceable | 1
R41 | Resistor |  | 23.7k | 23.7k / 1% / 0603 | 0603 | YAGEO | RC0603FR-0723K7L | replaceable | 1
R49 | Resistor |  | 31.6k | 31.6k / 1% / 0603 | 0603 | YAGEO | RC0603FR-0739RL | replaceable | 1
R50 | Resistor |  | 30.1k | 30.1k / 1% / 0603 | 0603 | PANASONIC | ERJ-3EKF1240V | replaceable | 1
S1 | Switch | KMR211GLFS | KMR211GLFS | Microminiature Tact Switch for SMT | KMR211GLFS | C&K Components | KMR211GLFS | ./. | 1
SW1 | Switch |  | DSHP04SSGER-G | DIP SW 4pol, 1.27mm | SO-8 | SWITRONIC | DSHP04SSGER-G | replaceable | 1
U1 |  |  |  | PanelBus DVI Receiver 165MHz, HSYNC fix | TQFP-100 | TI | TFP401A |  | 1
U2 | IC | SO | W25Q32JVSSIQ | 32Mbit Quad Serial Flash in SOIC W package | SO-8 WIDE | WINBOND | W25Q32JVSSIQ | W25Q32JVSSIQ | 1
U3 | IC |  | MIC6315-30D2UY | 3V VOLTAGE SUPERVISOR | SOT-143 | MICROCHIP | MIC6315-30D2UY | Power Monitor IC | 1
U4 |  | IC | PCA9306DCT | Bidirectional Translator | TSOP-8 | TI | PCA9306DCT |  | 1
VD1, VD2 |  | Green |  | SMD LED GREEN | 3216 | KINGBRIGHT | KP-3216MGC |  | 2
VD3 |  | Yellow |  | SMD LED YELLOW | 3216 | KINGBRIGHT | KP-3216SYC |  | 1
VD4 |  |  | B340A | Shottky restifiers, 2A, SMA Package | DO214AC | DIODES | B340A |  | 1
VD5, VD6 |  |  | 1N4148WS | Fast switching diode | SOD323 | VISHAY | 1N4148WS-E3-08 |  | 2
VD7, VD8 |  | Diode | B340A | Shottky restifiers, 2A, SMA Package | DO214AC | DIODES | B340A |  | 2
VD9 |  |  | PS2705A-1-F3-A | Photocoupler, SOP package | SOP-4 | RENESAS | PS2705A-1-F3-A |  | 1
X1 |  |  | ME030-508-02 | 2-pin HPWR connector |  | DECA SWITC | ME030-508-02 |  | 1
X10 |  |  | Molex_743201004 | DVI Connector | DVI / 29pole / 90° | AMTEK | DVIR-F29SWND-L |  | 1
XP1 |  | Connector |  | Header, 5-Pin, Dual row |  | FCI |  |  | 1
Y1 |  |  | 25MHz | SMD Oscillator with Stop Function | 3225 | YOKETANT | SO3225-025000-FIE-BBA-A1 |  | 1
 |  |  |  |  |  |  |  |  | 215
