sdadsp/LEDMAT3/FPGA/LED_MAT3_REV2/test_probe/probe_16b/probe_16b.html

probe_16b

2018.08.30.18:10:14 | Datasheet

Overview

Memory Map

## in_system_sources_probes_0

altera_in_system_sources_probes v17.1

Parameters

device_family | MAX10FPGA
gui_use_auto_index | true
sld_auto_instance_index | YES
sld_instance_index | 0
instance_id | PB16
probe_width | 16
source_width | 16
source_initial_value | 0
create_source_clock | false
create_source_clock_enable | false
enable_metastability | NO
deviceFamily | UNKNOWN
generateLegacySim | false

Software Assignments
(none)

generation took 0.01 seconds | rendering took 0.02 seconds
