sdadsp/LEDMAT3/(threads)

Thread 1 (2021-09-14):

Hello, I am learning your program, hope to wait for your guidance, thank you

gaoxueming, 2021-09-14:
您好，我学习您的程序中，希望等到您的指导，谢谢
Hello, I am learning your program, hope to wait for your guidance, thank you

sdadsp, 2021-09-15:
你好
If you have any questions, please ask. I will try to explain all details.

Regards,
Dmitry

gaoxueming, 2021-09-15:
哈哈，太好了，多谢您，我正在看您的程序，如下图。
您的程序真好，正是我需要的，再仔细查看。不过我是初学者，还是看起来很困难的。有没有解释性的文本等，可以参考的，当然没有就算了。只是这个版本包含哪些功能，这个我还没太看明白
我觉得您这个程序也是一直在更新，增减功能的吧？您能大致介绍一下目前这个版本的包含功能吗？
我也看了您的PCB和原理图，真的很不错，谢谢您。
如果您有微信什么的，能加一下好友吗？方便交流。18033720351，谢谢。

------------------&nbsp;原始邮件&nbsp;------------------
发件人:                                                                                                                        "sdadsp/LEDMAT3"                                                                                    ***@***.***&gt;;
发送时间:&nbsp;2021年9月15日(星期三) 下午4:19
***@***.***&gt;;
***@***.******@***.***&gt;;
主题:&nbsp;Re: [sdadsp/LEDMAT3] Hello, I am learning your program, hope to wait for your guidance, thank you (#1)

你好
 If you have any questions, please ask. I will try to explain all details.

Regards,
 Dmitry

—
You are receiving this because you authored the thread.
Reply to this email directly, view it on GitHub, or unsubscribe.
Triage notifications on the go with GitHub Mobile for iOS or Android.

gaoxueming, 2021-09-15:
另外，您这个是同步卡的程序工程。您有异步卡的工程吗？
谢谢您，您能读懂中文和用中文交流吗？上封邮件有点草率了，没想到语言的事情。

In addition, you this is the synchronization card program engineering.&nbsp;Do you have an asynchronous card project?

Thank you. Can you read and communicate in Chinese?&nbsp;Last email was a little hasty, I didn't think about the language.

------------------&nbsp;原始邮件&nbsp;------------------
发件人:                                                                                                                        "sdadsp/LEDMAT3"                                                                                    ***@***.***&gt;;
发送时间:&nbsp;2021年9月15日(星期三) 下午4:19
***@***.***&gt;;
***@***.******@***.***&gt;;
主题:&nbsp;Re: [sdadsp/LEDMAT3] Hello, I am learning your program, hope to wait for your guidance, thank you (#1)

你好
 If you have any questions, please ask. I will try to explain all details.

Regards,
 Dmitry

—
You are receiving this because you authored the thread.
Reply to this email directly, view it on GitHub, or unsubscribe.
Triage notifications on the go with GitHub Mobile for iOS or Android.

sdadsp, 2021-09-15:
再一次问好
I can translate Chinese, but I cannot read it directly. Nevertheless, you may write me in Chinese, that is Ok.
And I will add more notes about firmware functionality, on Sunday. Ok?

This project is not for any asynchronous card, sorry. If needed, we can try to add more features.

By the way, I need your confirmation by scanning the WeChat QR code (the application asked to activate a friend invitation):
https://www.dropbox.com/s/aztsor5qkmgw2x0/Screenshot_20210915-113350_WeChat.jpg?dl=0

sdadsp, 2021-09-15:
they updated QR-code:
https://www.dropbox.com/s/9532sgcwe58m1v9/Screenshot_20210915-114134_WeChat.jpg?dl=0

gaoxueming, 2021-09-15:
真的太感谢了，您能抽空帮我注释，真的非常感谢。
我是在研究异步卡，但是没有别的资料，非常幸运在git上看到了您的程序，能够参考学习。
另外您哪个网址连接我打不开的，您有QQ或者微信号码吗？可以加我
我的QQ号码就是这个593490948

------------------&nbsp;原始邮件&nbsp;------------------
发件人:                                                                                                                        "sdadsp/LEDMAT3"                                                                                    ***@***.***&gt;;
发送时间:&nbsp;2021年9月15日(星期三) 下午4:37
***@***.***&gt;;
***@***.******@***.***&gt;;
主题:&nbsp;Re: [sdadsp/LEDMAT3] Hello, I am learning your program, hope to wait for your guidance, thank you (#1)

再一次问好
 I can translate Chinese, but I cannot read it directly. Nevertheless, you may write me in Chinese, that is Ok.
 And I will add more notes about firmware functionality, on Sunday. Ok?

This project is not for any asynchronous card, sorry. If needed, we can try to add more features.

By the way, I need your confirmation by scanning the WeChat QR code (the application asked to activate a friend invitation):
 https://www.dropbox.com/s/aztsor5qkmgw2x0/Screenshot_20210915-113350_WeChat.jpg?dl=0

—
You are receiving this because you authored the thread.
Reply to this email directly, view it on GitHub, or unsubscribe.
Triage notifications on the go with GitHub Mobile for iOS or Android.

sdadsp, 2021-09-15:
you are welcome.

I am not a WeChat user. I just install WeChat application, and it asked to send the QR code (see the link) to a referral friend. This is needed for registering me as a new user.

gaoxueming, 2021-09-15:
等一下吧，我应该一会儿可以打开连接了，包括可以上谷歌

------------------&nbsp;原始邮件&nbsp;------------------
发件人:                                                                                                                        "sdadsp/LEDMAT3"                                                                                    ***@***.***&gt;;
发送时间:&nbsp;2021年9月15日(星期三) 下午4:48
***@***.***&gt;;
***@***.******@***.***&gt;;
主题:&nbsp;Re: [sdadsp/LEDMAT3] Hello, I am learning your program, hope to wait for your guidance, thank you (#1)

you are welcome.

I am not a WeChat user. I just install WeChat application, and it asked to send the QR code (see the link) to a referral friend. This is needed for registering me as a new user.

—
You are receiving this because you authored the thread.
Reply to this email directly, view it on GitHub, or unsubscribe.
Triage notifications on the go with GitHub Mobile for iOS or Android.

sdadsp, 2021-09-15:
actually, the difference between synchronous and asynchronous LED cards is not big. My controller has a memory which can freeze the picture if the connection with a image source is broken.

gaoxueming, 2021-09-15:
hi ，我已经可以打开连接了，需要您更新二维码，之前的已经过期了，麻烦再发一下，然后我就可以扫码了

------------------&nbsp;原始邮件&nbsp;------------------
发件人:                                                                                                                        "sdadsp/LEDMAT3"                                                                                    ***@***.***&gt;;
发送时间:&nbsp;2021年9月15日(星期三) 下午4:53
***@***.***&gt;;
***@***.******@***.***&gt;;
主题:&nbsp;Re: [sdadsp/LEDMAT3] Hello, I am learning your program, hope to wait for your guidance, thank you (#1)

actually, the difference between synchronous and asynchronous LED cards is not big. My controller has a memory which can freeze the picture if the connection with a image source is broken.

—
You are receiving this because you authored the thread.
Reply to this email directly, view it on GitHub, or unsubscribe.
Triage notifications on the go with GitHub Mobile for iOS or Android.

sdadsp, 2021-09-15:
okay,
what the WeChat is asking now:
1) Open WeChat, search for "WeChat Team", tap "Account", and select "Help Friend Register"
2) enter my mobile number: +79037741155

gaoxueming, 2021-09-15:
已经OK了，我这边已经操作，但是是按照+7（国家区号）9037741155 ，不知道是不是操作完全正确

------------------&nbsp;原始邮件&nbsp;------------------
发件人:                                                                                                                        "sdadsp/LEDMAT3"                                                                                    ***@***.***&gt;;
发送时间:&nbsp;2021年9月15日(星期三) 下午5:02
***@***.***&gt;;
***@***.******@***.***&gt;;
主题:&nbsp;Re: [sdadsp/LEDMAT3] Hello, I am learning your program, hope to wait for your guidance, thank you (#1)

okay,
 what the WeChat is asking now:

Open WeChat, search for "WeChat Team", tap "Account", and select "Help Friend Register"

enter my mobile number: +79037741155

—
You are receiving this because you authored the thread.
Reply to this email directly, view it on GitHub, or unsubscribe.
Triage notifications on the go with GitHub Mobile for iOS or Android.

sdadsp, 2021-09-15:
谢谢，已经搞定了。
你的 ID 是 18033720351 吗？

gaoxueming, 2021-09-15:
是的

------------------&nbsp;原始邮件&nbsp;------------------
发件人:                                                                                                                        "sdadsp/LEDMAT3"                                                                                    ***@***.***&gt;;
发送时间:&nbsp;2021年9月15日(星期三) 下午5:11
***@***.***&gt;;
***@***.******@***.***&gt;;
主题:&nbsp;Re: [sdadsp/LEDMAT3] Hello, I am learning your program, hope to wait for your guidance, thank you (#1)

谢谢，已经搞定了。
 你的 ID 是 18033720351 吗？

—
You are receiving this because you authored the thread.
Reply to this email directly, view it on GitHub, or unsubscribe.
Triage notifications on the go with GitHub Mobile for iOS or Android.

gaoxueming, 2022-01-08:
hi 我的微信登陆不了了，需要好友验证，麻烦你发我微信这个数字，223588，帮我好友验证，谢谢，我微信好友不多，所以只能拜托你了，谢谢

---Original---
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

gaoxueming, 2022-01-08:
你加我另一个微信吧18032435613

---Original---
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

sdadsp, 2022-01-11:
Hello !

sorry for the late reply...
I am in Almaty city ( Kazakhstan) now.
Internet was disconnected here for a week..
I will reply you within days.

regards,
Dimitry

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

sdadsp, 2022-01-12:
你好，美好的一天。
抱歉，我几乎一星期都不能上网。
现在我在线，随时准备为您提供帮助

сб, 8 янв. 2022 г. в 09:59, gaoxueming ***@***.***>:

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

sdadsp, 2024-04-18:
Hi and good day.

My wechat account stopped working.

How is your project going?

Dimitry.

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
