sdadsp/LEDMAT3/PCB/LED_MAT_3/Release2/Project Outputs for LED_MAT_3/Schematics/LED_MAT_3_Schematics.pdf

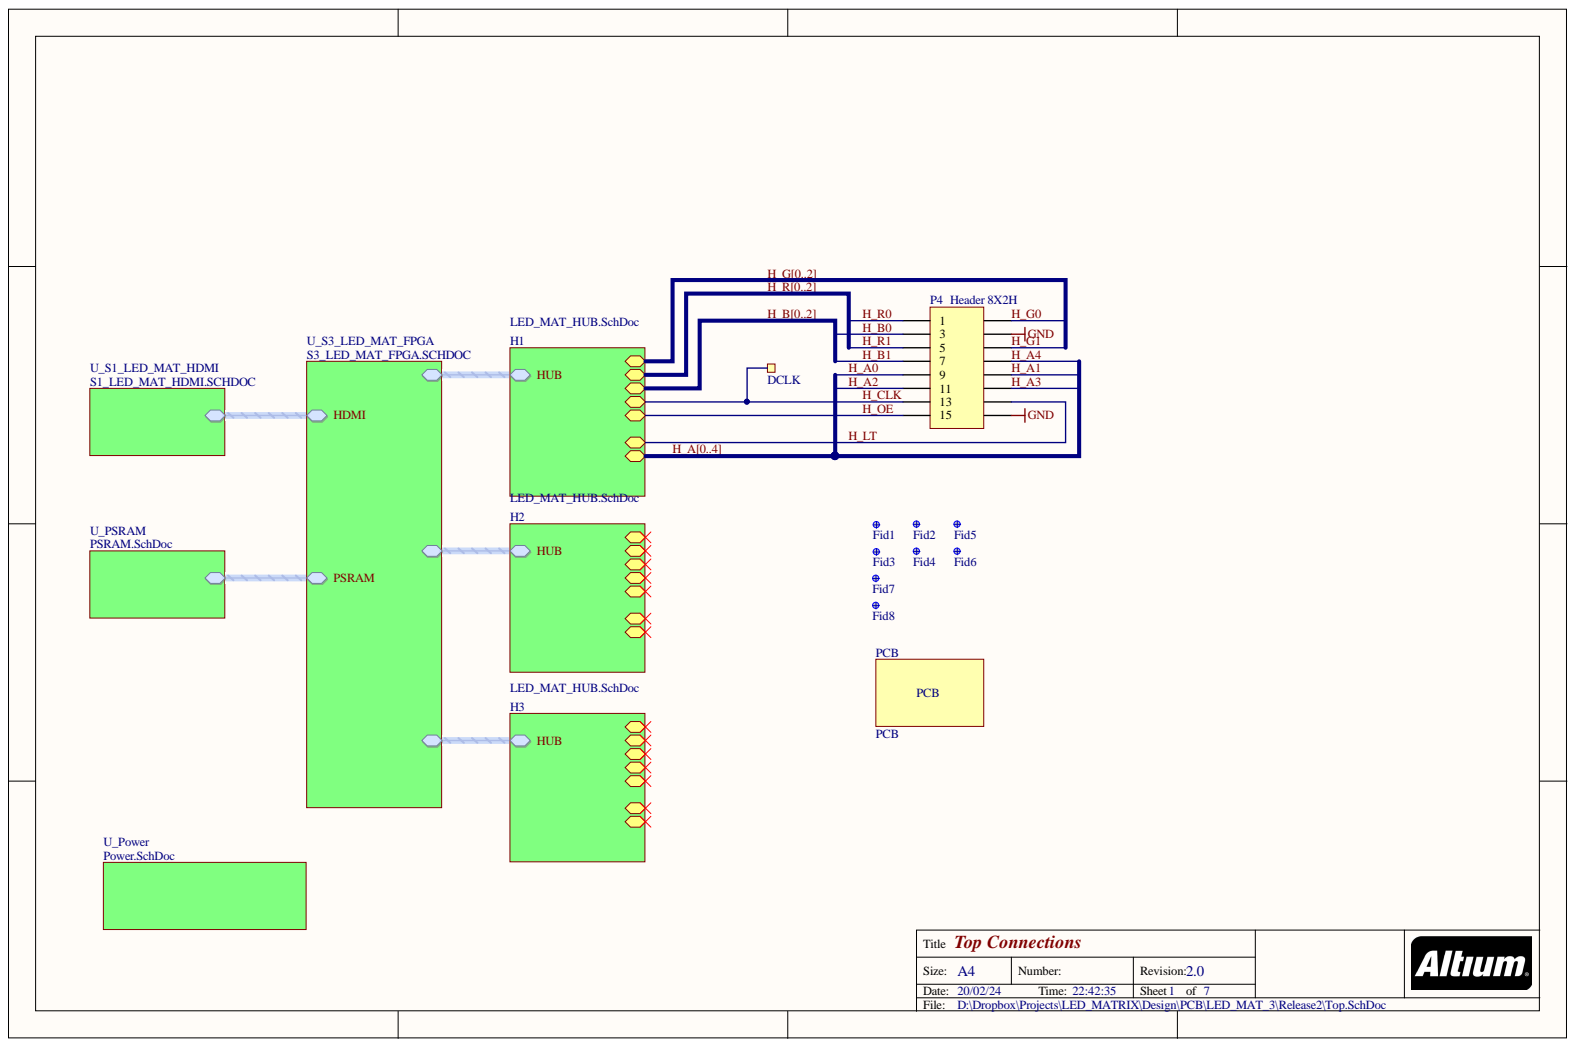
[picture p38: page 1]

DCLK | H_A2 | H_A3

H_CLK
H_OE

Top Connections Title

A4 Size: | Number: | 2.0 Revision:

Date: 20/02/24 Time: 22:42:35 | | Sheet 1 of 7
File: D:\Dropbox\Projects\LED_MATRIX\Design\PCB\LED_MAT_3\Release2\Top.SchDoc

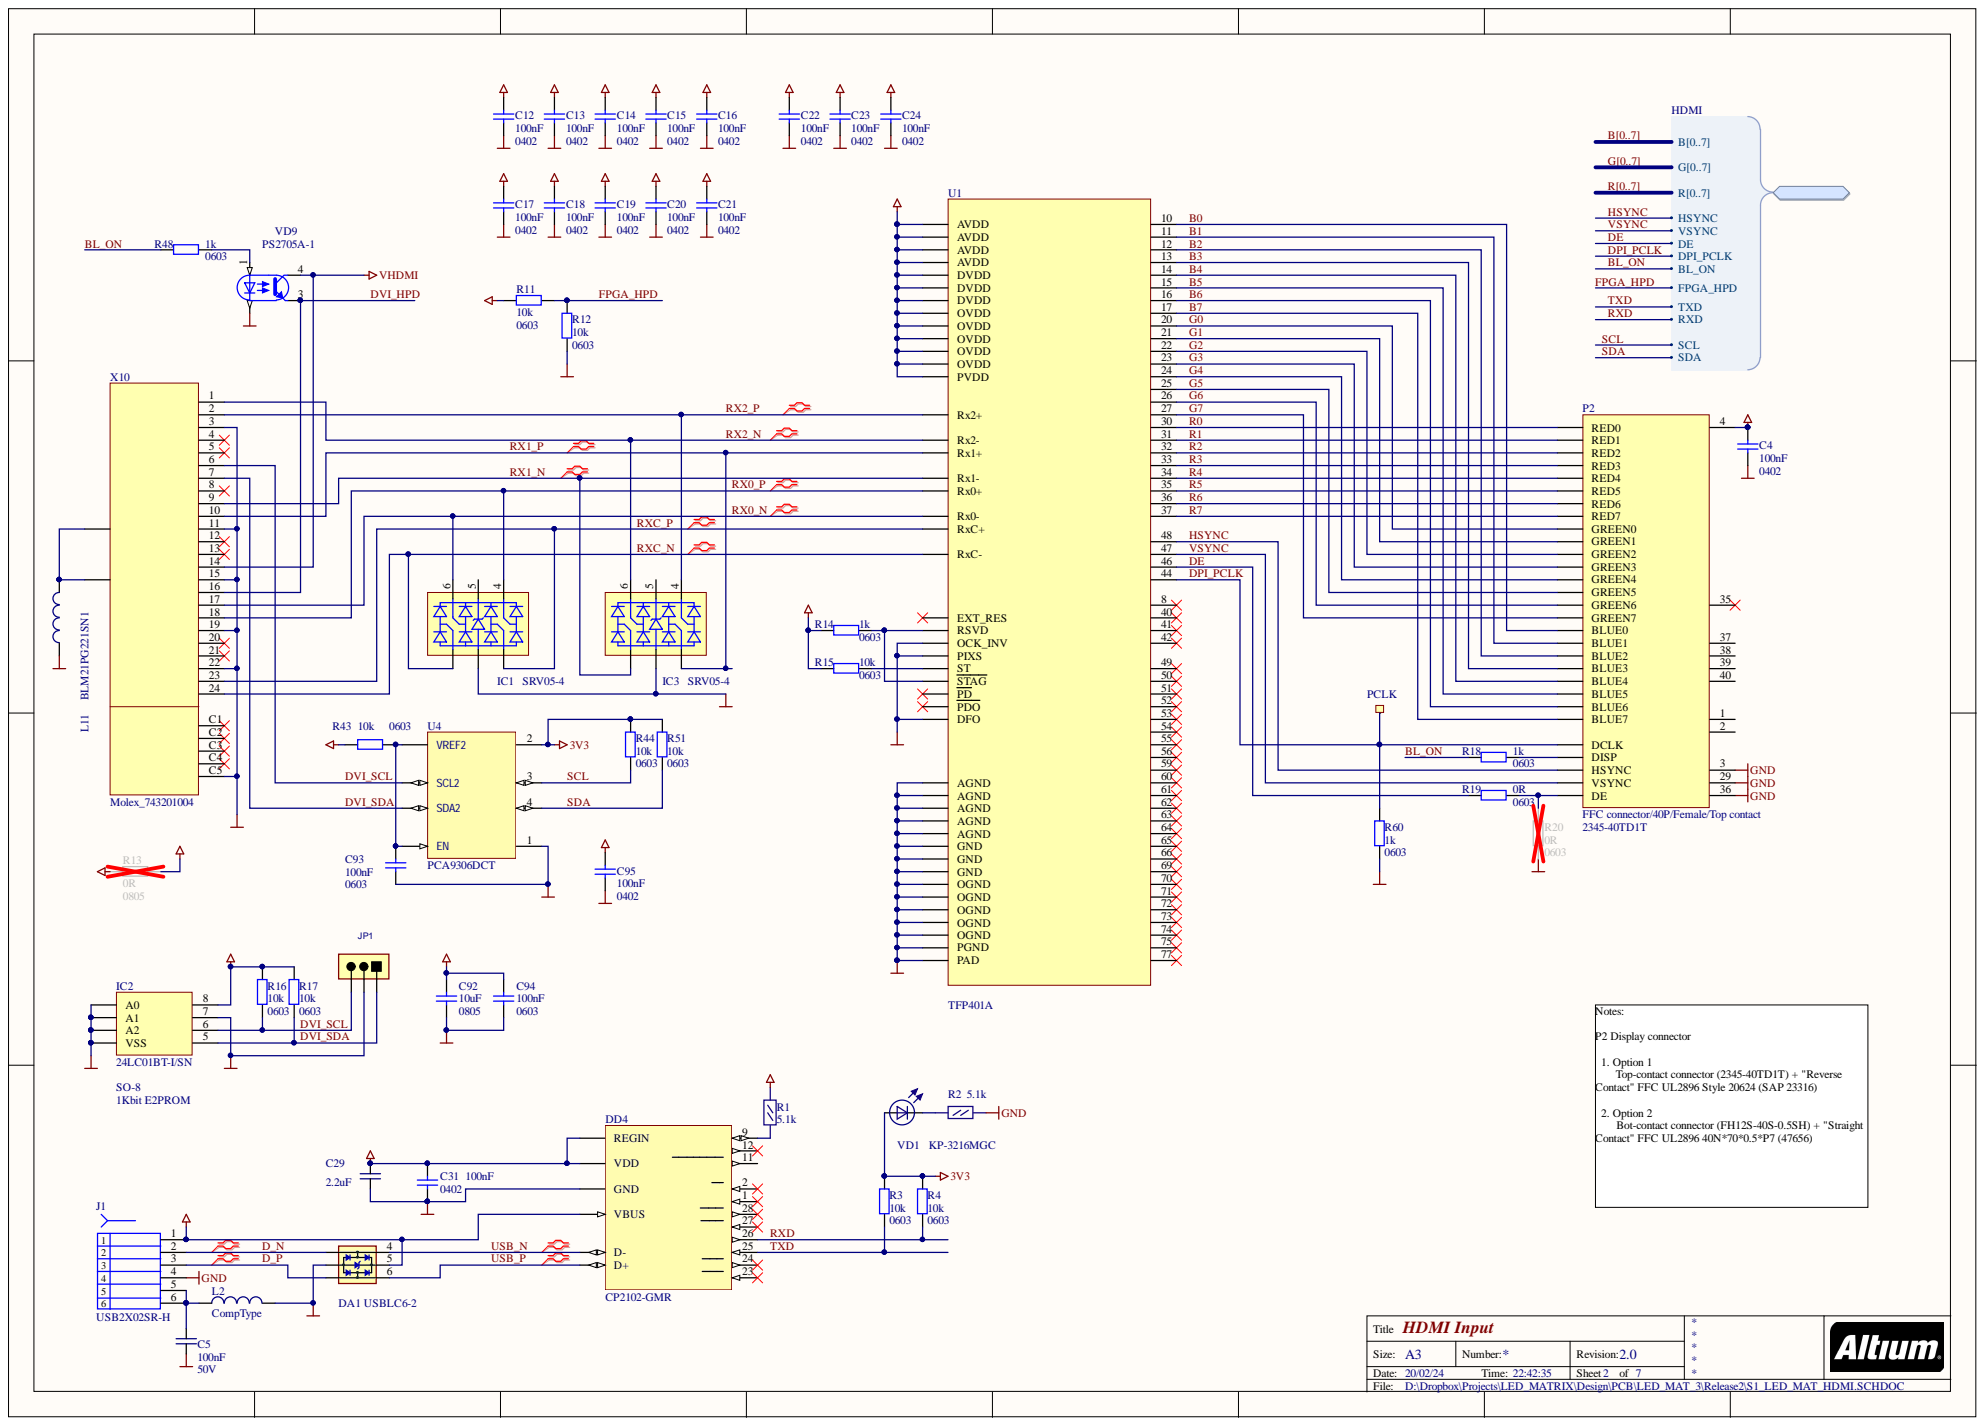
[picture p39: page 2]

1 1 | B 1
1 2 | B 2

1 6 | B 6
1 7 | B
2 0

2 1
2 2
2 3

2 5
2 6

5 | R X 1 _P | 3 2
6 | R X 1 _N | | 3 3

8 | R X 0_P | | 3 5
9 | | | | 3 6
1 0 | | R X 0_N | | 3 7
1 1 | R X C _P | | | | 4 8
1 2 | | R X C _N | | | | H S Y N C

1 4 | | 4 6 | D E
1 5 | 4 4 | D P I _P C L K

1 7
1 8 | 4 0
1 9 | | R 1 4 | 4 1

2 4 | | | 5 1 | P C L K
C 1 | R 4 3 1 0 k 0 6 | 0 | 5 2

T i t l e HDMI Inpu t | **** *

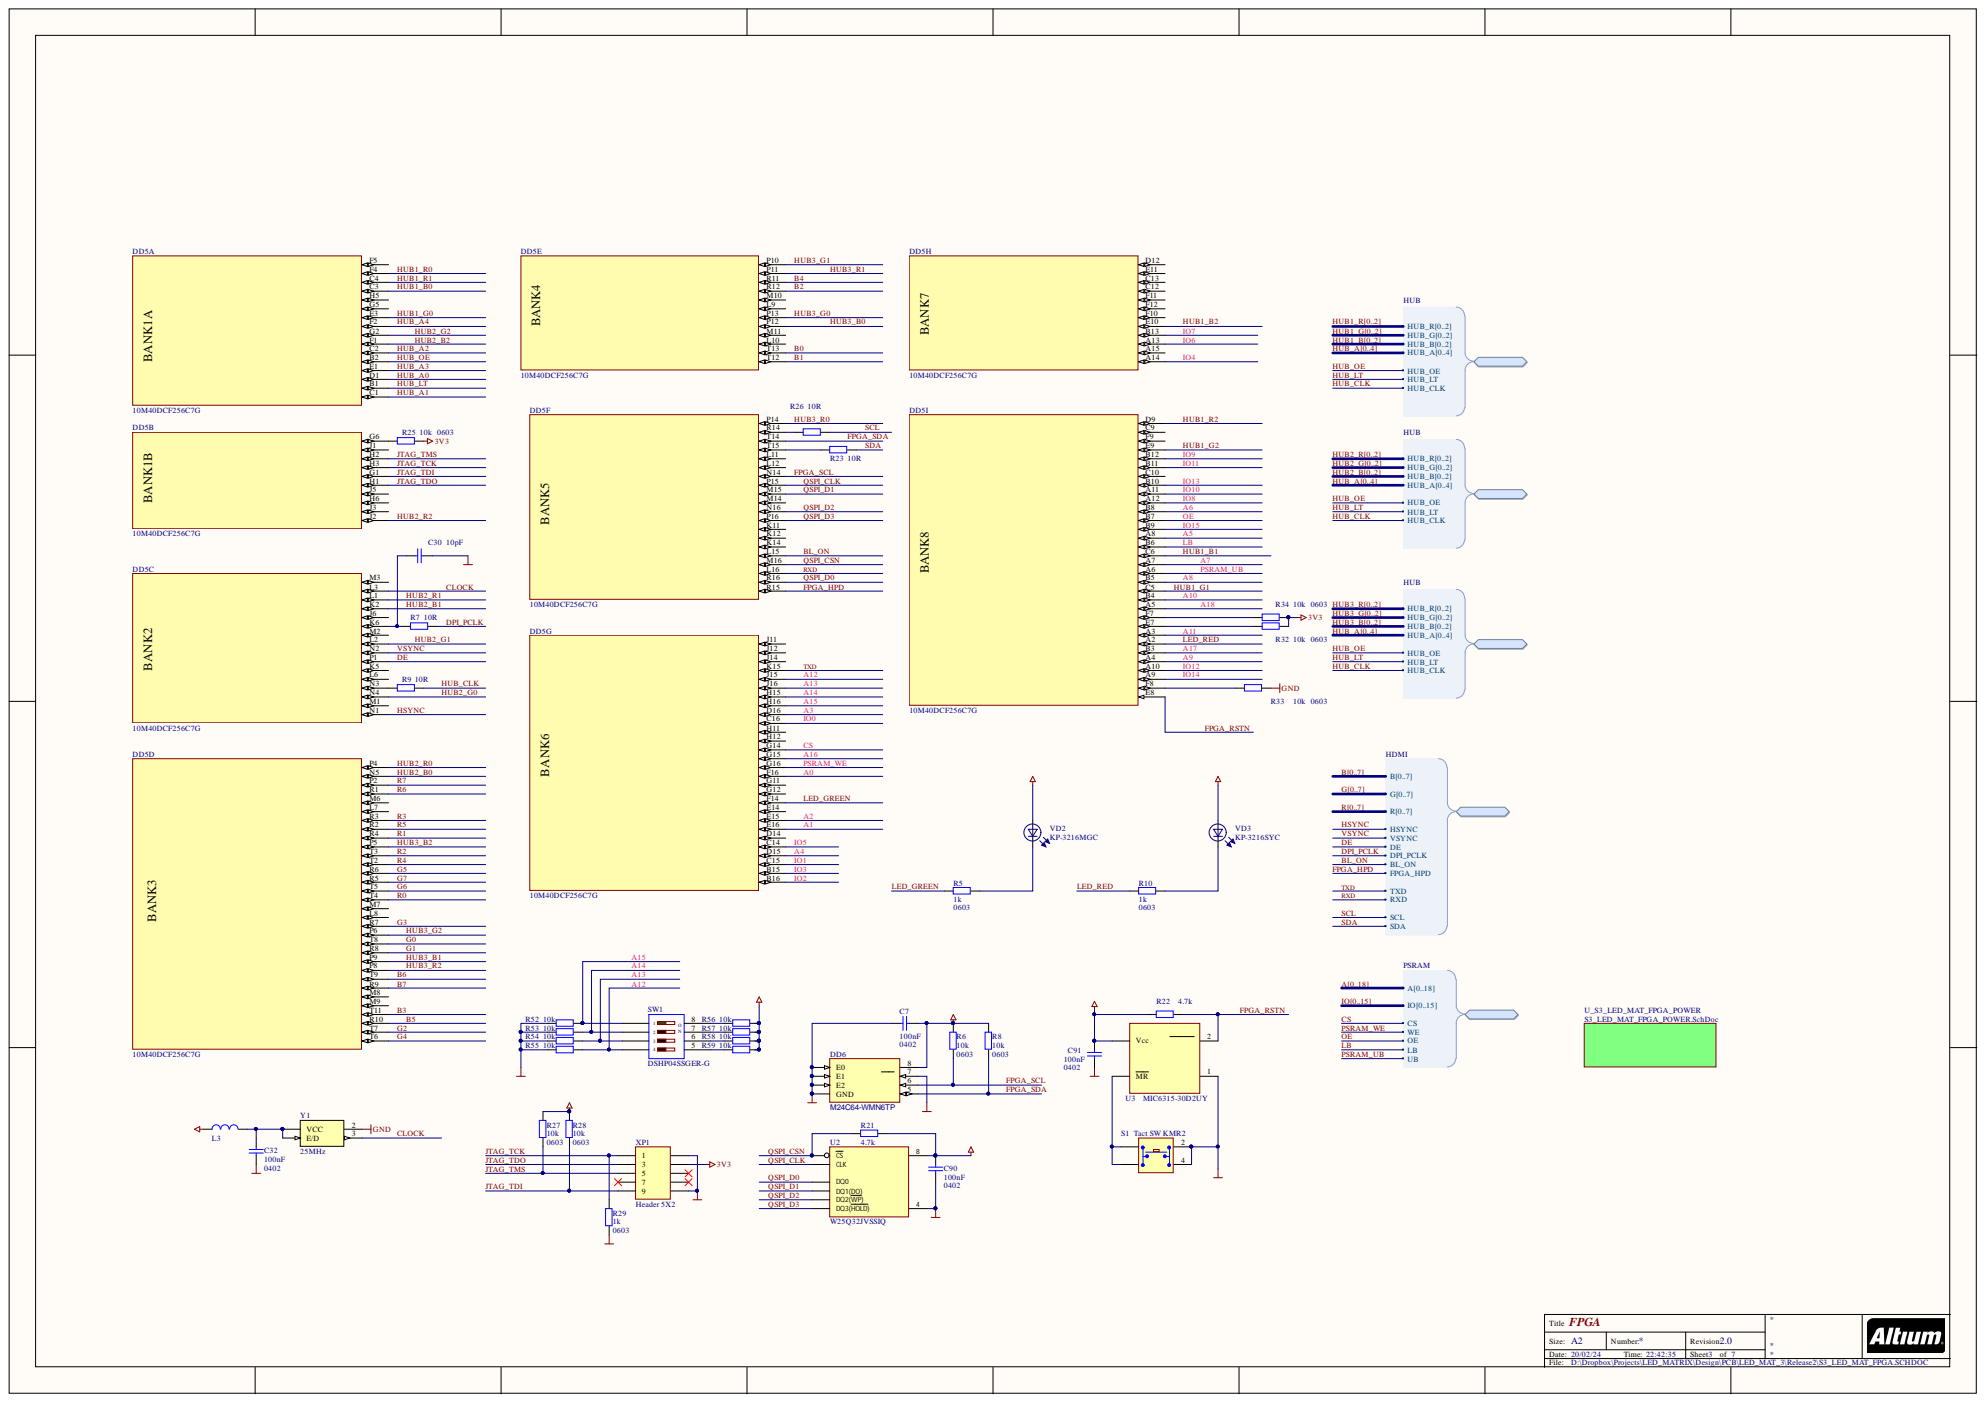
[picture p40: page 3]

H 1 6 A 1 5 | F P G A _ R STN

S i z e : A 2 | N umb e r : * | R e v isi o n : 2.0
D a t e : 2 0 / 0 2 / 2 4 Time : 2 2 : 4 2 : 3 5 | | S h e e t 3 o f 7

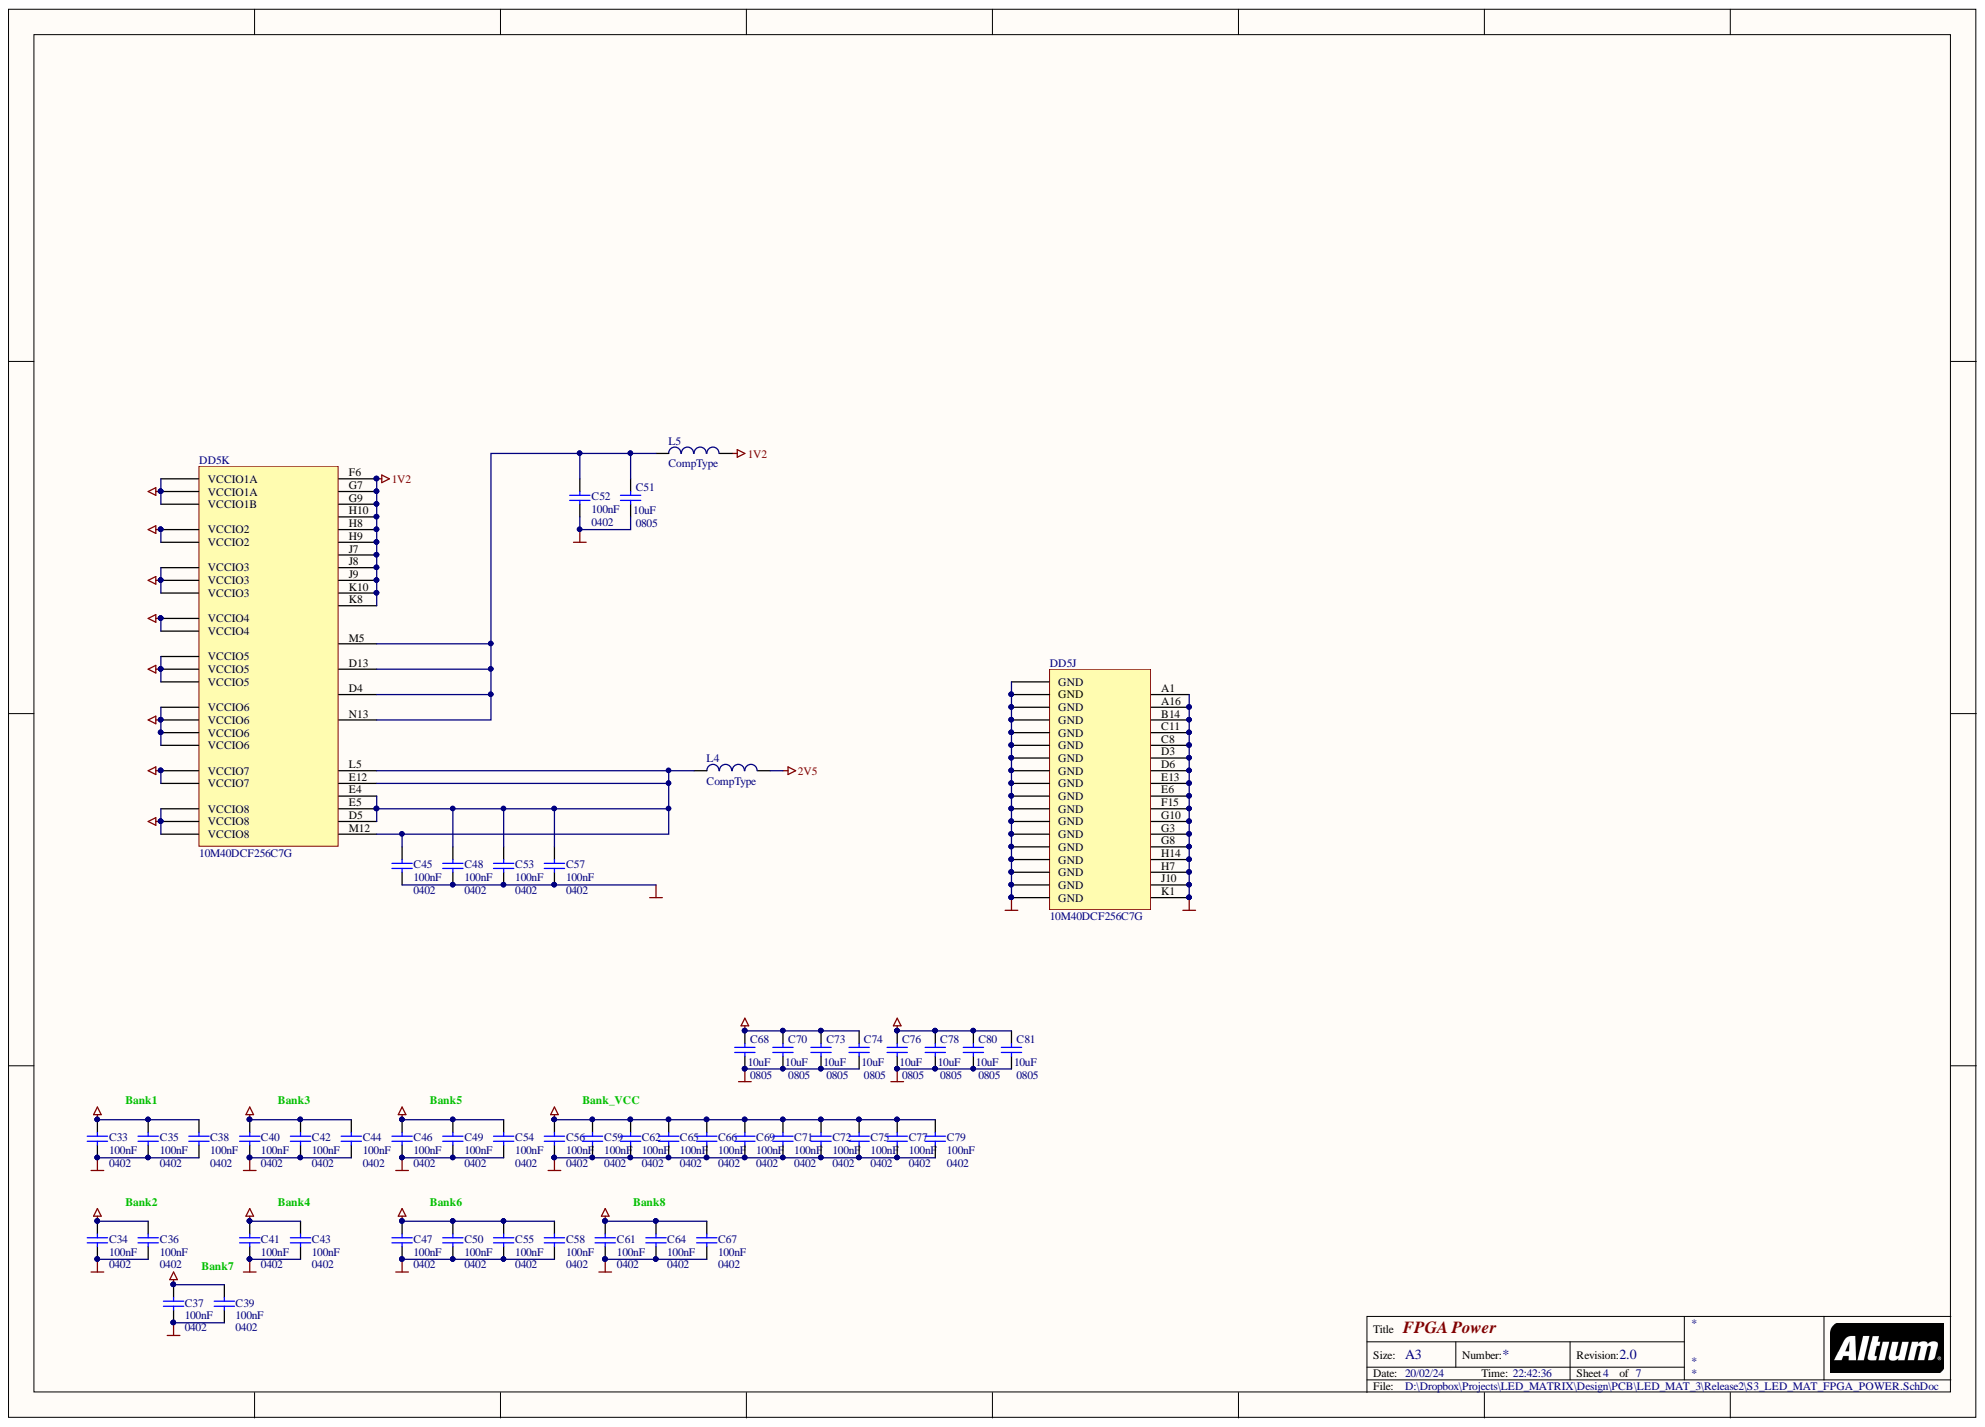
[picture p41: page 4]

FPGA Power Title | * * *

Size: A3 | Number: * | Revision: 2.0

Date: 20/02/24 Time: 22:42:36 | | Sheet 4 of 7

D:\Dropbox\Projects\LED_MATRIX\Design\PCB\LED_MAT_3\Release2\S3_LED_MAT_FPGA_POWER.SchDoc

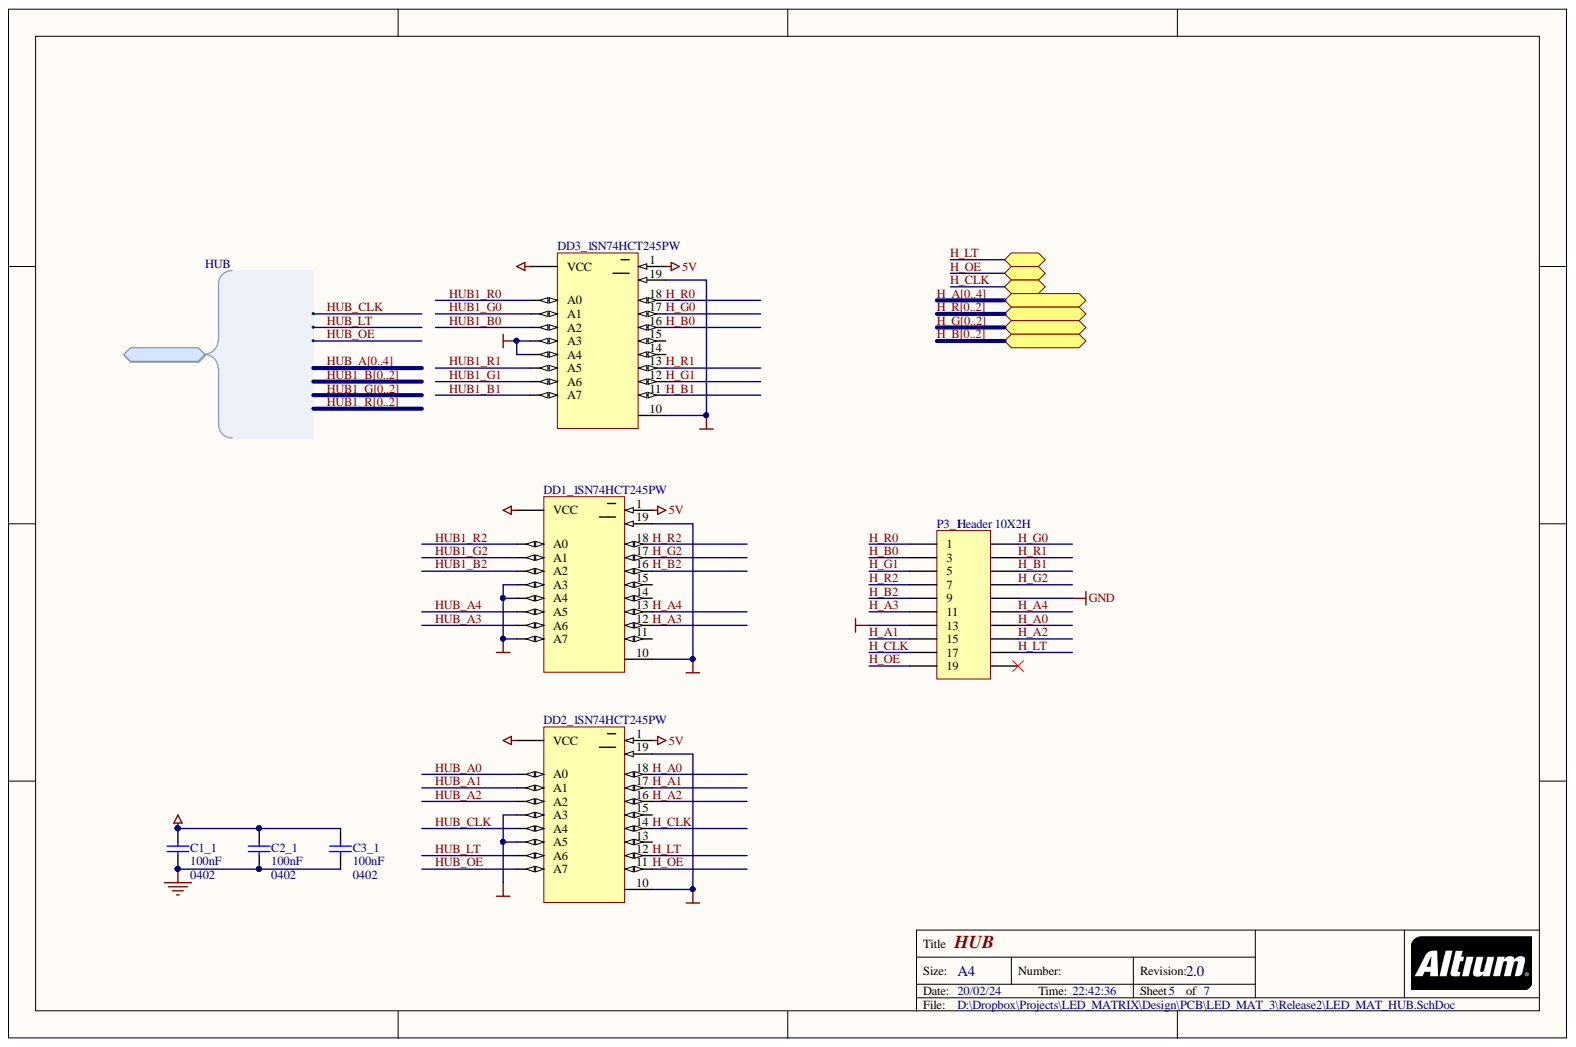
[picture p42: page 5]

HUB Title

A4 Size: | Number: | 2.0 Revision:

Date: 20/02/24 Time: 22:42:36 | | Sheet 5 of 7
File: D:\Dropbox\Projects\LED_MATRIX\Design\PCB\LED_MAT_3\Release2\LED_MAT_HUB.SchDoc

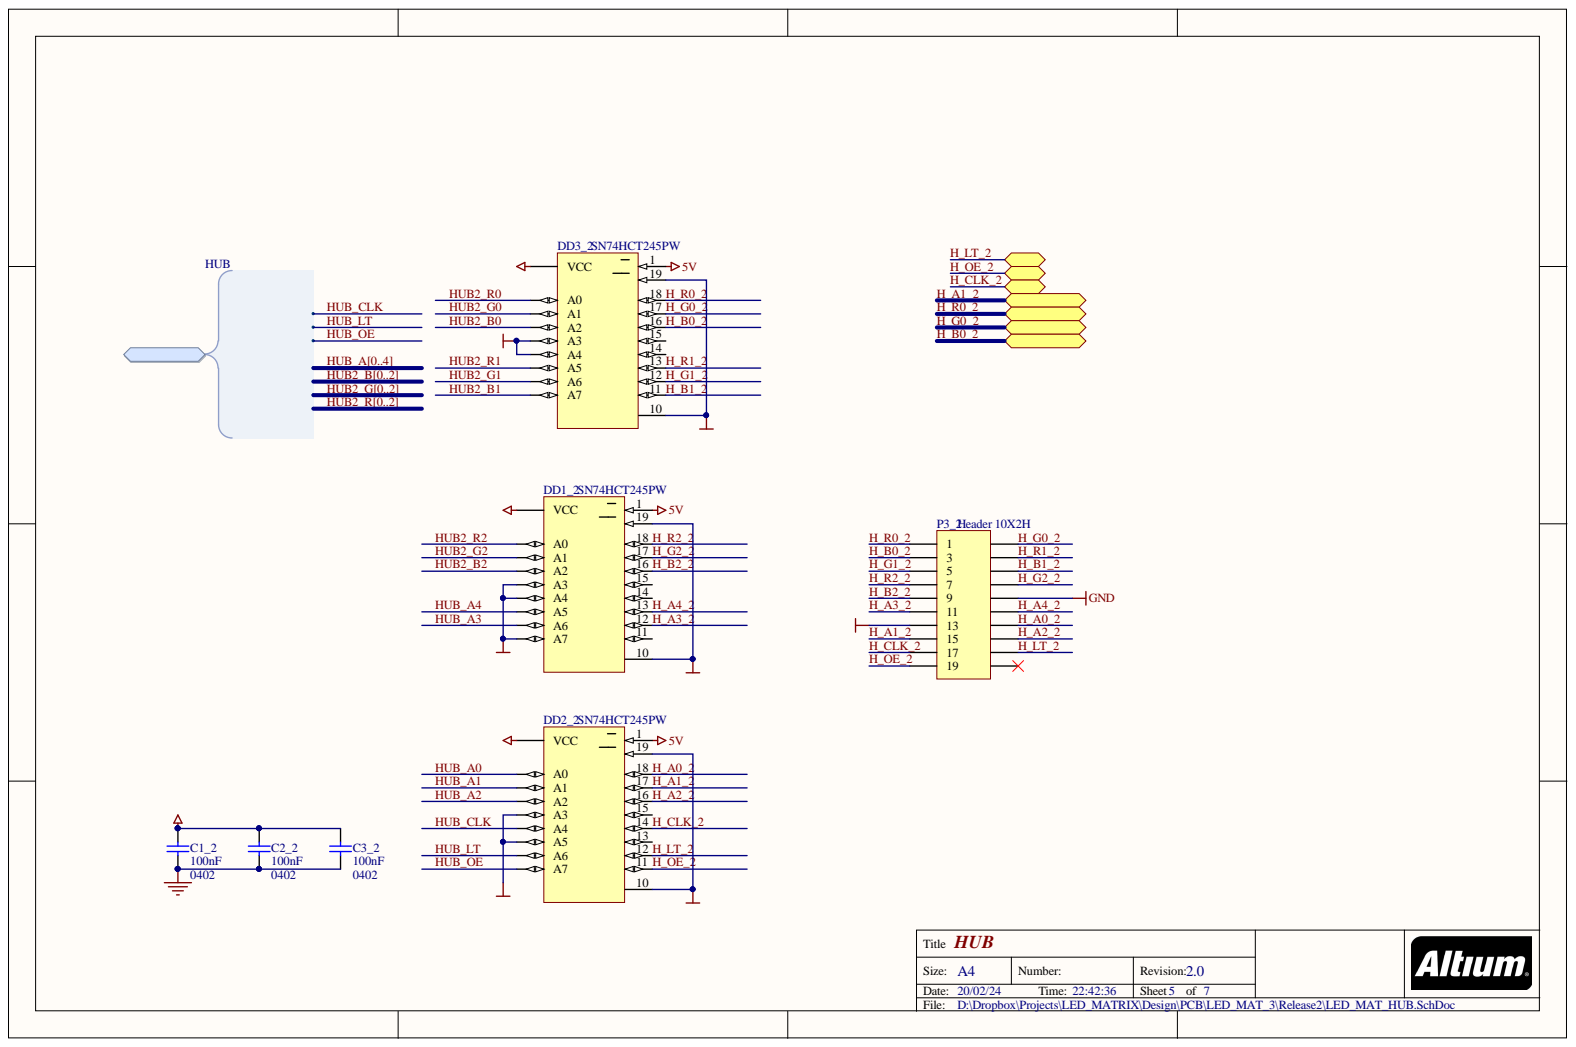
[picture p43: page 6]

HUB Title

A4 Size: | Number: | 2.0 Revision:

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

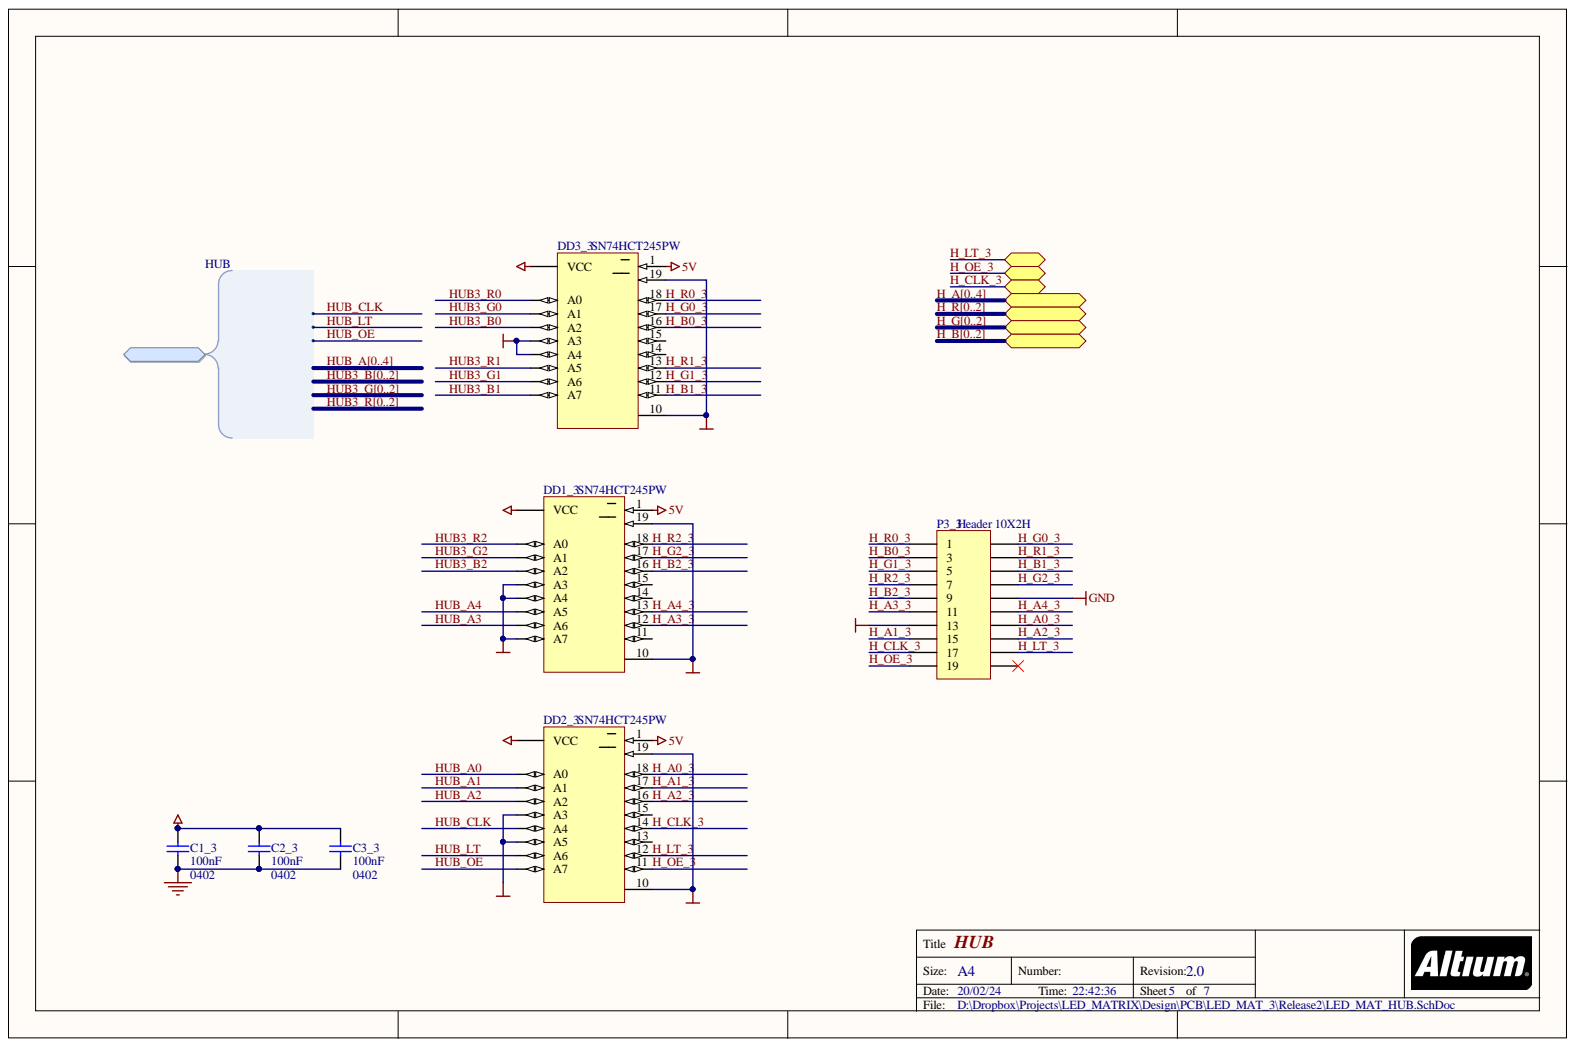
[picture p44: page 7]

HUB Title

A4 Size: | Number: | 2.0 Revision:

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

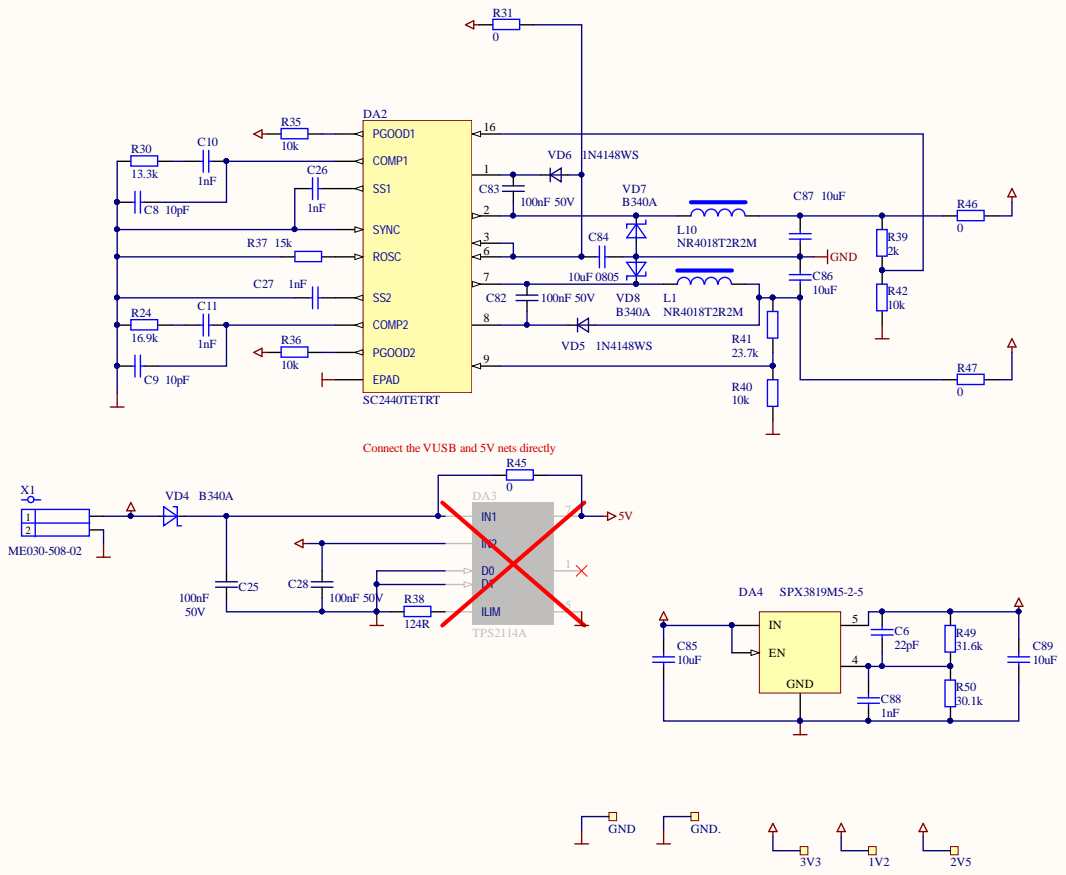
[picture p45: page 8]

Connect the VUSB and 5V nets directly

Title Power

Size: A3 | Number: Power | Revision: 2.0

Date: 20/02/24 Time: 22:42:36 | | Sheet 6 of 7

D:\Dropbox\Projects\LED_MATRIX\Design\PCB\LED_MAT_3\Release2\Power.SchDoc

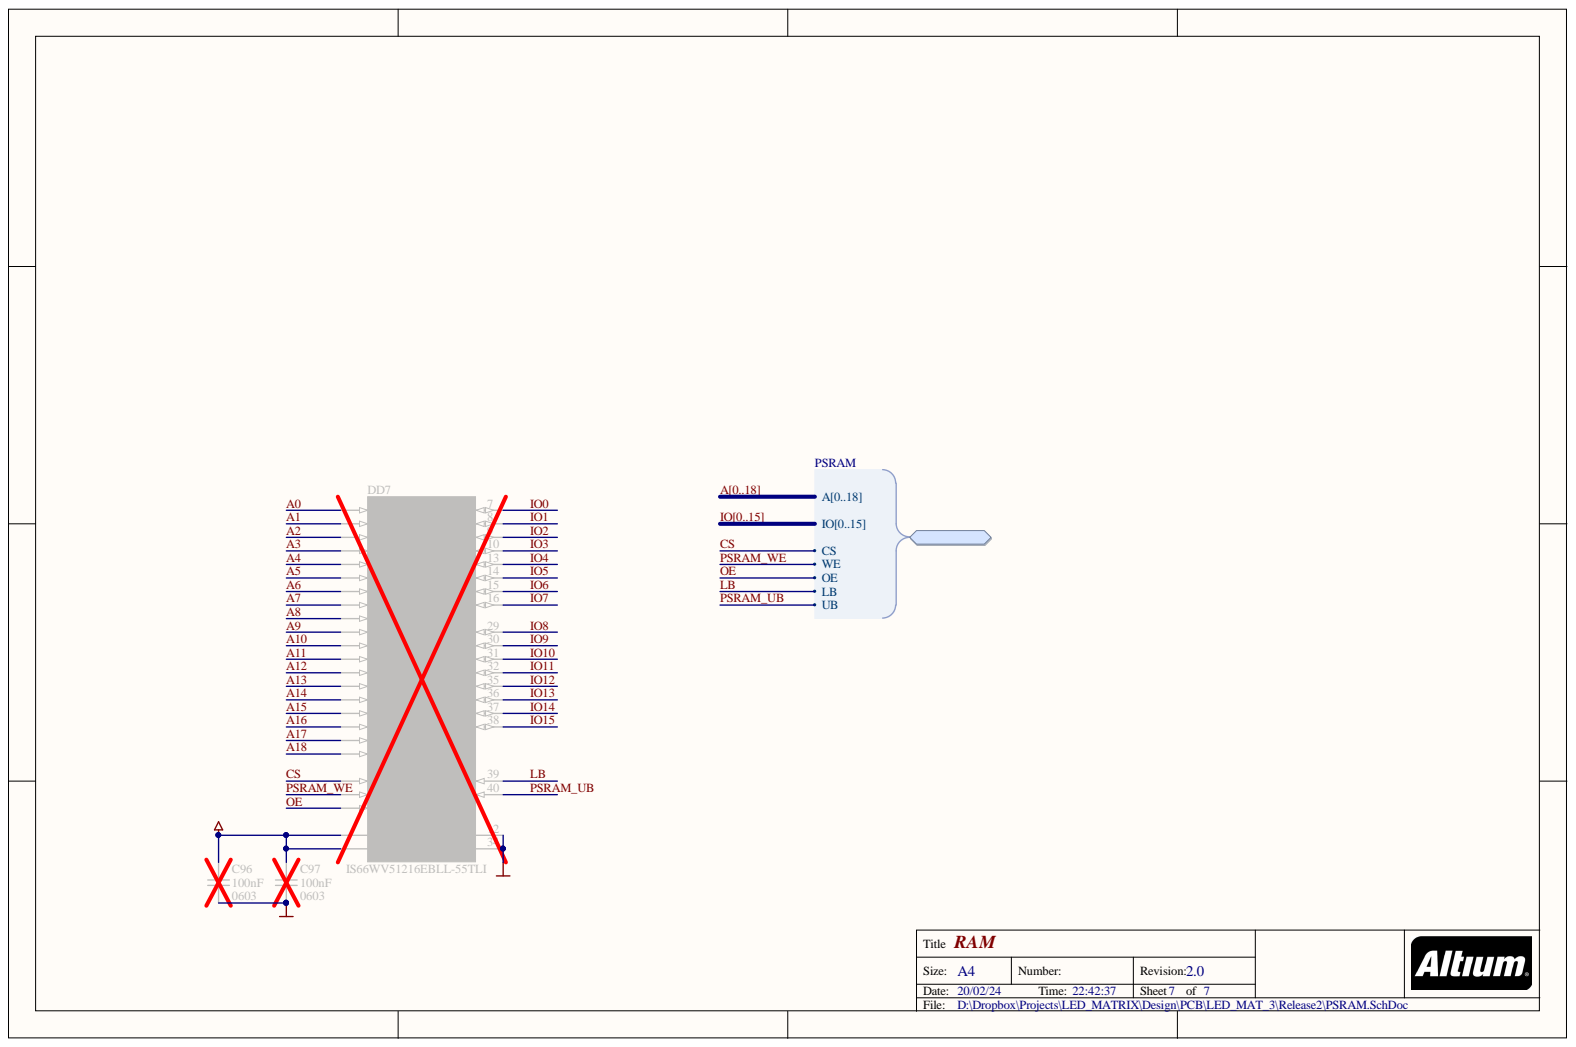
[picture p46: page 9]

A 4 | Numbe r : | 2.0 R evision:

D ate : Time : | | She e t 7 of 7
File : I X\D esign\P C B\LED_MAT_3\R ele ase2\P S R AM. S chDoc

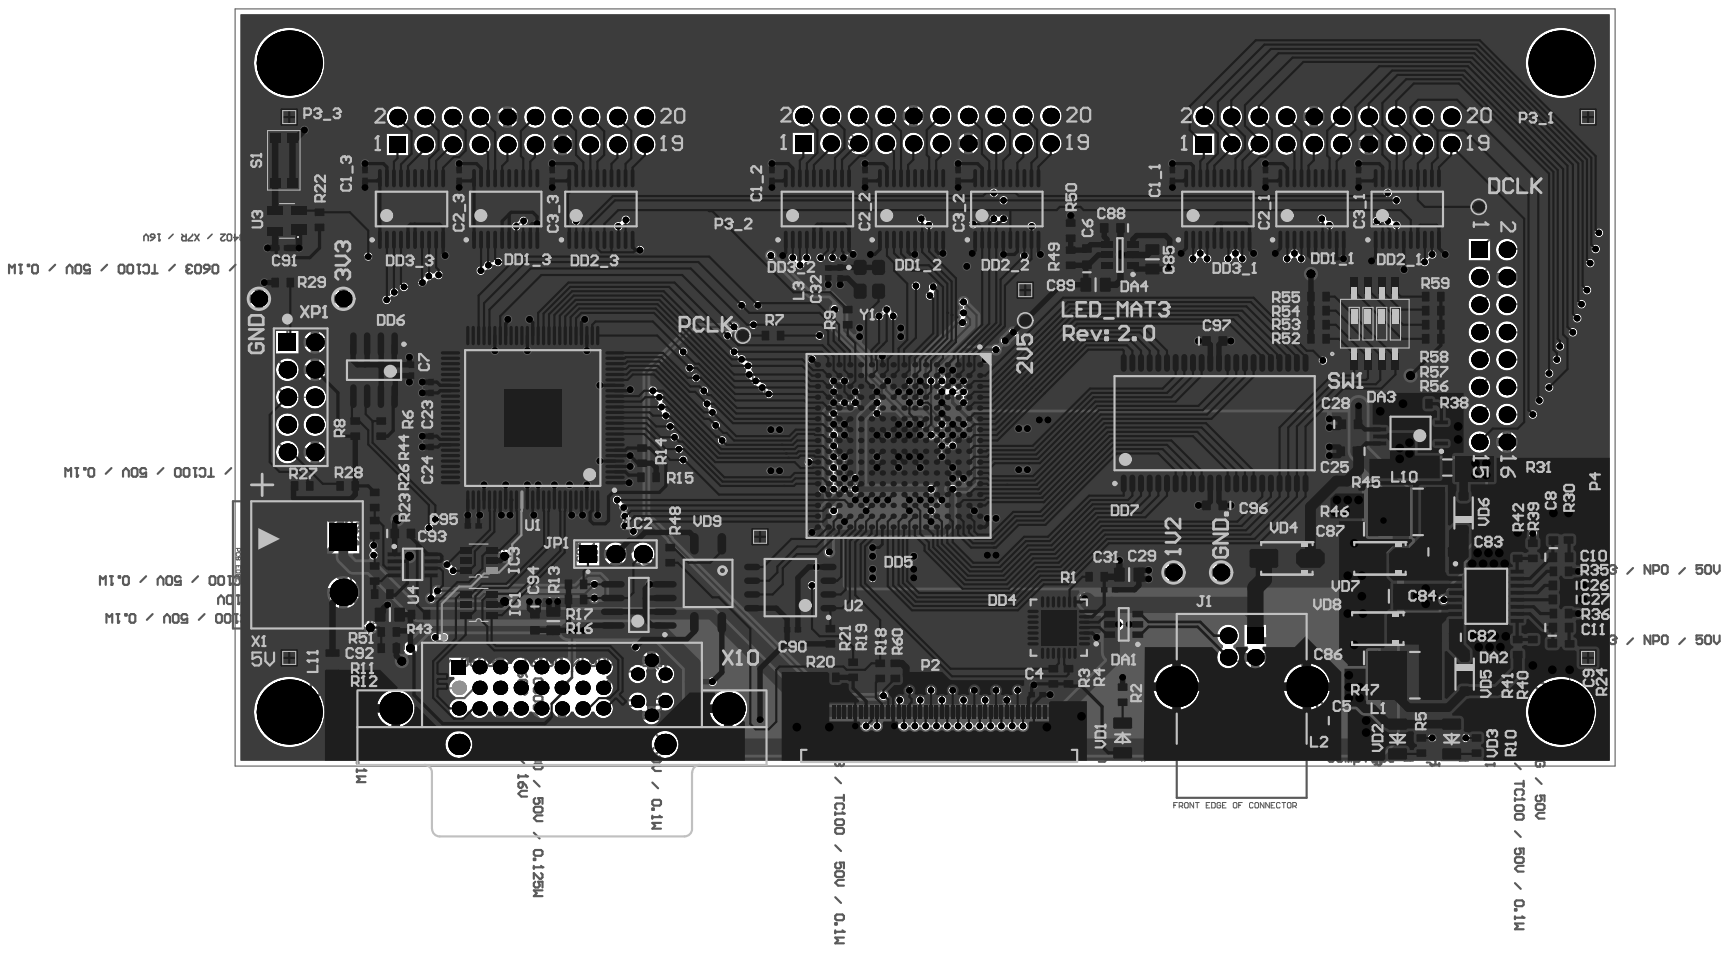
[picture p47: page 10]
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
