sdadsp/LEDMAT3/(list of files, drawings)

Other design files:
PCB/LED_MAT_3/Release2/LED_MAT_3.PRJPCB
PCB/LED_MAT_3/Release2/LED_MAT_HUB.SchDoc
PCB/LED_MAT_3/Release2/Panel for LED_MAT-20180829-1100.PcbDoc
PCB/LED_MAT_3/Release2/Power.SchDoc
PCB/LED_MAT_3/Release2/PSRAM.SchDoc
PCB/LED_MAT_3/Release2/S1_LED_MAT_HDMI.SCHDOC
PCB/LED_MAT_3/Release2/S3_LED_MAT_FPGA.SCHDOC
PCB/LED_MAT_3/Release2/S3_LED_MAT_FPGA_POWER.SchDoc
PCB/LED_MAT_3/Release2/Top.SchDoc
