sdadsp/LEDMAT3/FPGA/LED_MAT3_REV2/outbuf_dpram/outbuf_dpram_inst.v

outbuf_dpram	outbuf_dpram_inst (
	.data ( data_sig ),
	.rdaddress ( rdaddress_sig ),
	.rdclock ( rdclock_sig ),
	.rden ( rden_sig ),
	.wraddress ( wraddress_sig ),
	.wrclock ( wrclock_sig ),
	.wren ( wren_sig ),
	.q ( q_sig )
	);
