sdadsp/LEDMAT3/FPGA/LED_MAT3_REV2/test_probe/probe_16b/synthesis/probe_16b.v

// probe_16b.v

// Generated using ACDS version 17.1 593

`timescale 1 ps / 1 ps
module probe_16b (
		input  wire [15:0] probe,  //  probes.probe
		output wire [15:0] source  // sources.source
	);

	altsource_probe_top #(
		.sld_auto_instance_index ("YES"),
		.sld_instance_index      (0),
		.instance_id             ("PB16"),
		.probe_width             (16),
		.source_width            (16),
		.source_initial_value    ("0"),
		.enable_metastability    ("NO")
	) in_system_sources_probes_0 (
		.source     (source), // sources.source
		.probe      (probe),  //  probes.probe
		.source_ena (1'b1)    // (terminated)
	);

endmodule
