sdadsp/LEDMAT3/(commit log)

2020-02-24 Project is added
    [BOM_LED_MAT_3.xls, LED_MAT_3.PRJPCB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]
2023-07-15 minor fixes to registers' file and matrix control; HPD pin starts with 3000ms delay (for generating sync pulses optionally: see Doc)
    [hub75_drv.v, led_mat3.v, led_mat_core.v, outbuf_dpram_multi.v, regfile_uart_mapper.v, test_pattern_generator.v]
